iocoder/graduation/README

+------------------------------------------------------------------------------+
|                            MY GRADUATION PROJECT                             |
+------------------------------------------------------------------------------+

             ,----------------,              ,---------,
        ,-----------------------,          ,"        ,"|
      ,"                      ,"|        ,"        ,"  |
     +-----------------------+  |      ,"        ,"    |
     |  .-----------------.  |  |     +---------+      |
     |  |                 |  |  |     | -==----'|      |
     |  |  I LOVE MIPS!   |  |  |     |         |      |
     |  |  QUAFIOS> _     |  |  |/----|`---=    |      |
     |  |                 |  |  |   ,/|==== ooo |      ;
     |  |                 |  |  |  // |(((( [33]|    ,"
     |  `-----------------'  |," .;'| |((((     |  ,"
     +-----------------------+  ;;  | |         |,"
        /_)______________(_/  //'   | +---------+        <from asciiworld.com>
   ___________________________/___  `,
  /  oooooooooooooooo  .o.  oooo /,   \,"-----------
 / ==ooooooooooooooo==.o.  ooo= //   ,`\--{)B     ,"
/_==__==========__==_ooo__ooo=_/'   /___________,"
`-----------------------------'

Manifesto:
----------
doc/        Detailed documentation for my work
firmware/   Firmware program for MIPS computer
hardware/   VHDL code for the machine
mipsemu/    MIPS computer emulator
quafios/    Quafios operating system
vhdsim/     VHDL code simulation with nvc (VHPI)

Notes:
------
-> You need gcc and SDL to compile the emulator (mipsemu).
-> You need to cross compile binutils, gcc, and libgcc to compile the firmware
   * Note: before you compile libgcc, please add 'HOST_LIBGCC2_CFLAGS=-mxgot'
     to 'libgcc/config/mips/t-mips' file in gcc source code.
