iocoder/graduation/doc/book/poster.pdf

## MIPS COMPUTER ON FPGA

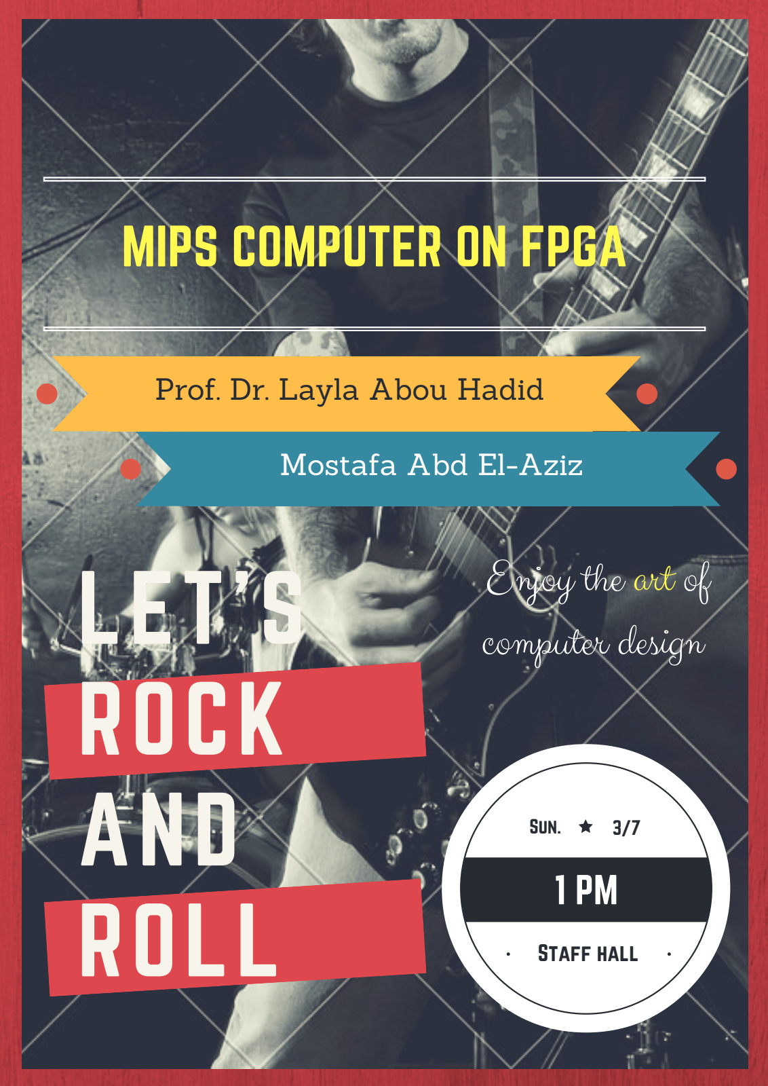
[picture p35: page 1]

# LET'S ROCK AND ROLL

Prof. Dr. Layla Abou Hadid

Mostafa Abd El-Aziz

Sun. 3/7

### 1 PM

Staff hall

## Enjoy the art of computer design
