iocoder/graduation/doc/presentation/presentation.pdf

# MIPS COMPUTER ON FPGA

## Supervisor: Professor Layla Abou Hadid Team: Mostafa Abd El-Aziz

# Overview

- The target of the project is to build a general-purpose computer system on FPGA.
- General-purpose computer?
- FPGA: Spartan-3E chip on Nexys II development board.

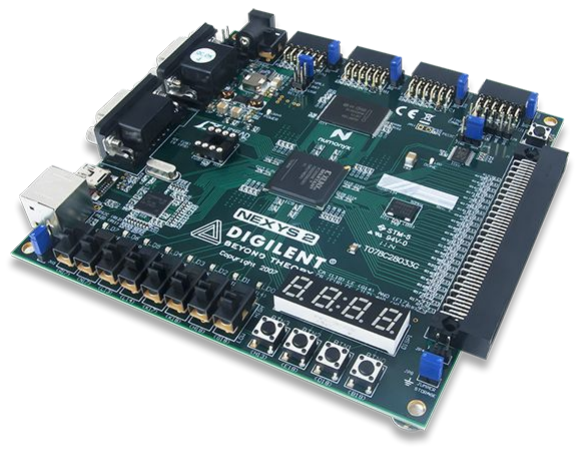
[picture p36: figure]
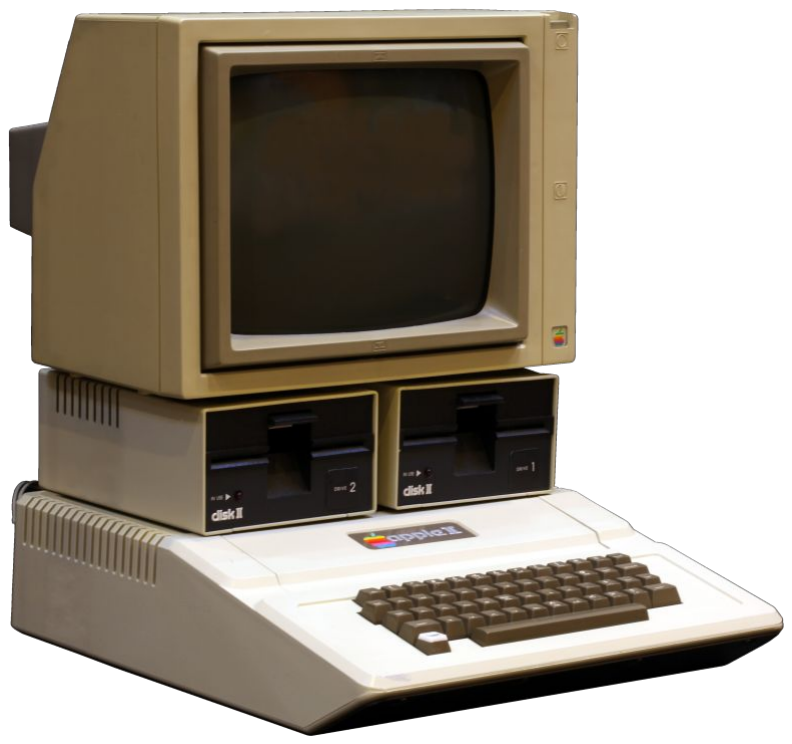
[picture p37: figure]

# WHY?

- Argument: There are tons of MIPS processors implemented in VHDL and Verilog!
- Fallacy: MIPS processors… not MIPS computers.
- Research the capabilities of FPGAs vs. capabilities of modern micro-computers.
- Computer architecture education in CSED (That’s why we chose MIPS).
- Processor-oriented education vs. system-oriented education (Clements vs. Peterson).
- Fun.

# Goal

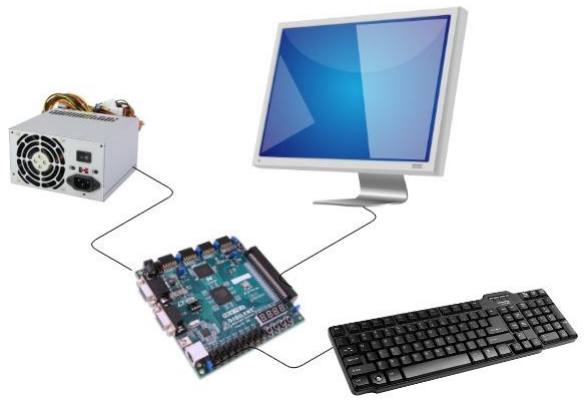
[picture p38: figure]

- General-purpose computer:
- Capabilities?
- Limitations?
- Users: Gamers - Students - Hobbyists
- Processor: MIPS-I ISA (pipeline, cache, and paging).
- Interfaces: VGA (output) and PS/2 (input).
- Hardware: MIPS processor + I/O interfaces in VHDL.
- Software: Firmware and OS [Quafios].

# Outline

- High-Level Architecture
- System components:
- Processor
- Memory
- VGA
- PS/2 Keyboard
- Interrupt Subsystem
- Timer
- Emulation
- Software
- Firmware
- OS
- Conclusion

# Outline

- High-Level Architecture
- System components:
- Processor
- Memory
- VGA
- PS/2 Keyboard
- Interrupt Subsystem
- Timer
- Emulation
- Software
- Firmware
- OS
- Conclusion

# System Architecture

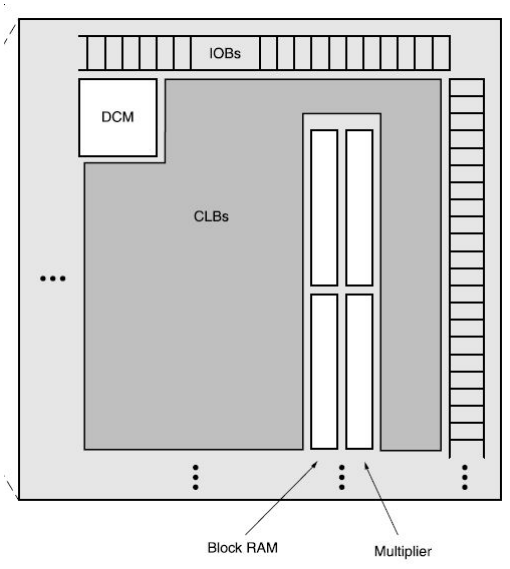
[picture p39: figure]

- Challenges:
- Low clock rate.
- LUTs, multiplexers, adders, etc…
- Block RAMs: only 20 slices.
- Limited distributed RAM.
- Timing constraints!
- These limited resources led to various design decisions:
- The choice of MIPS architecture (RISC merits).
- Direct-mapped TLB and caches.
- Text-mode VGA.
- Precise exceptions.

# System Architecture: High Level

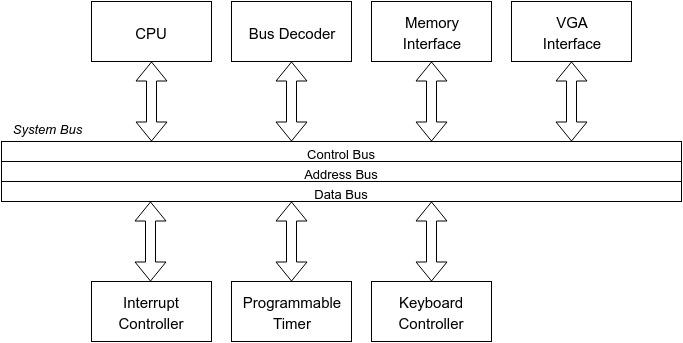
[picture p40: figure]

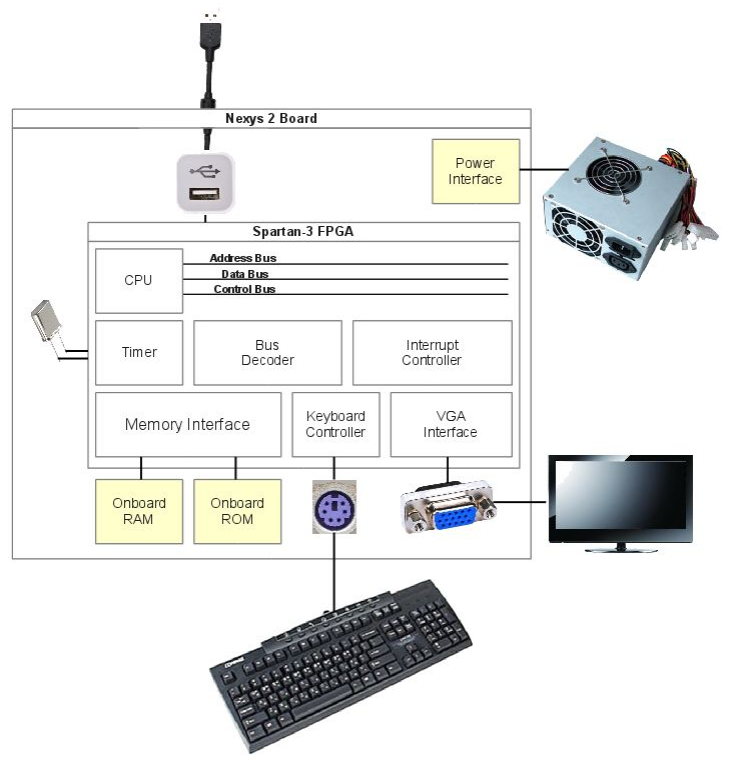
[picture p41: figure]

# System Architecture: High Level

# Outline

- High-Level Architecture
- System components:
- Processor
- Memory
- VGA
- PS/2 Keyboard
- Timer
- Interrupt Controller
- Emulation
- Software
- Firmware
- OS
- Conclusion

# Central Processing Unit (1/6)

- The CPU consists of three components:
- The core (pipeline).
- Caching sub-system: instruction cache and data cache.
- Software-controlled translation-lookaside buffer (TLB).
- The CPU is actually an implementation of MIPS-I instruction set architecture:
- 58 instructions: memory access, ALU, branch/jump, and misc instructions.
- 32 general purpose registers + HI and LO registers.
- Additions (compatible with IDT’s R3000):
- Control instructions: MFC0, MTC0, TLBR, TLBWI, and RFE.
- Control registers: Index, EntryLo, BadVaddr, EntryHi, SR, Cause, and EPC.
- Transparent cache.
- Software-controlled TLB.

# Pipeline

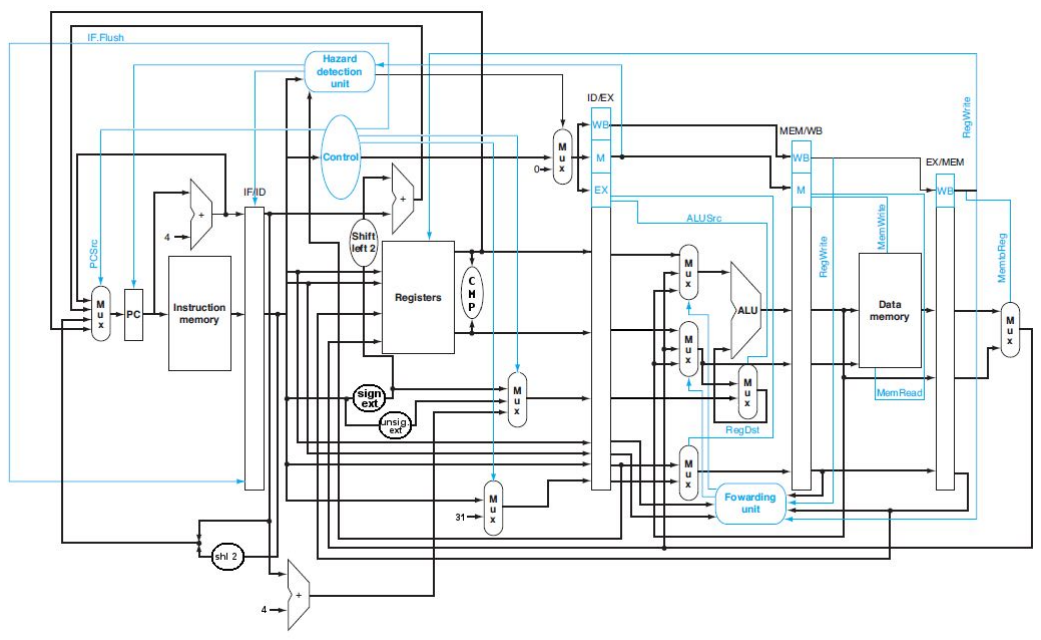
[picture p42: figure]

# Address Translation

# Address Translation

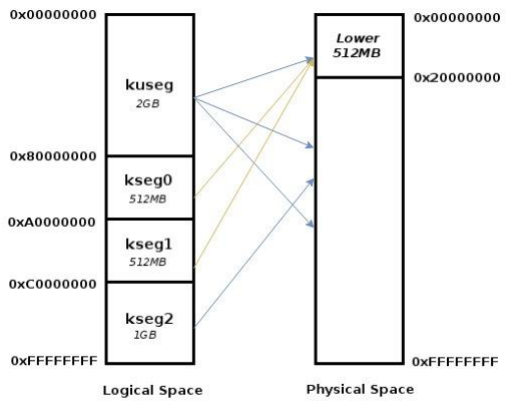
[picture p43: figure]

# Memory (2/6)

- MIPS-I physical address space is 4GB.
- Nexys II board contains two memory chips:
- 16MB Pseudo-static RAM chip.
- 16MB ROM chip.
- VHDL interface between the chips and system bus.
- Memory-mapped I/O

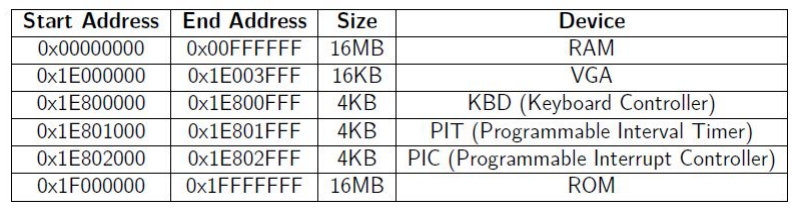
[picture p44: figure]

# VGA Interface (3/6)

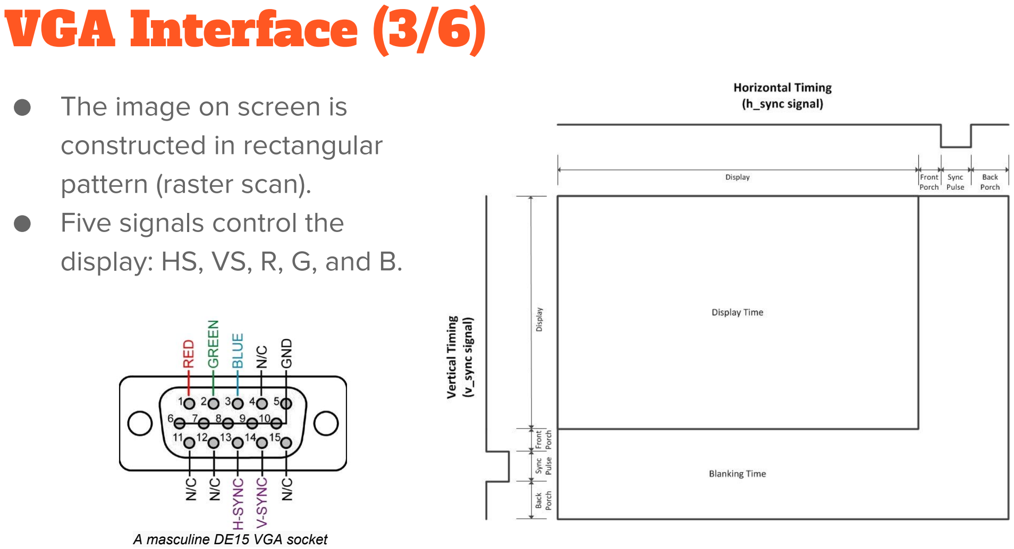
[picture p45: page 16]

- The image on screen is
constructed in rectangular pattern (raster scan).
- Five signals control the display: HS, VS, R, G, and B.

A masculine DE15 VGA socket

# VGA Interface: CRT Screen

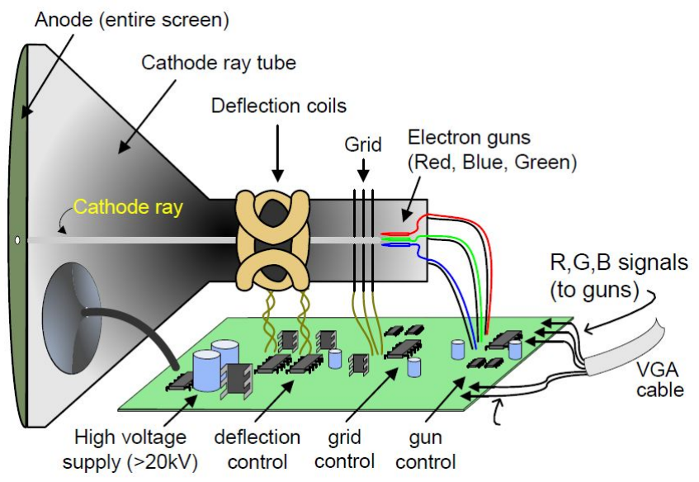
[picture p46: figure]

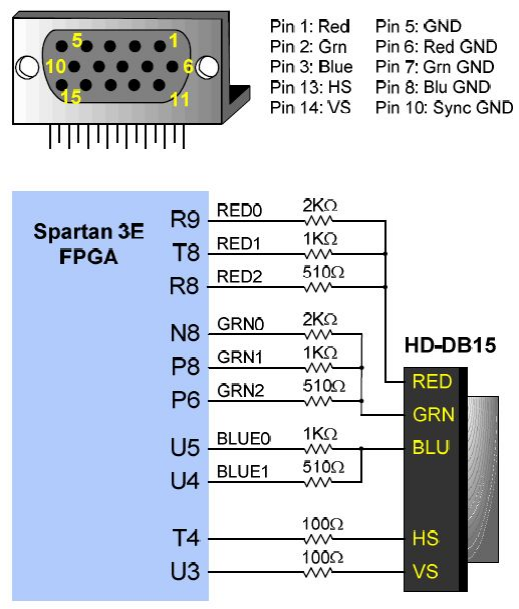
[picture p47: figure]

# VGA Interface

- Nexys II board provides a DE15 VGA port. HS and VS signals are directly connected to the Spartan 3E FPGA chip.
- Since R, G, and B are analog singnals, a DAC circuit is put between FPGA chip and VGA
port.
- FPGA could produce 8 levels of red color, 8 levels of green, and 4 levels of blue (total 256 colors).

# VGA Interface

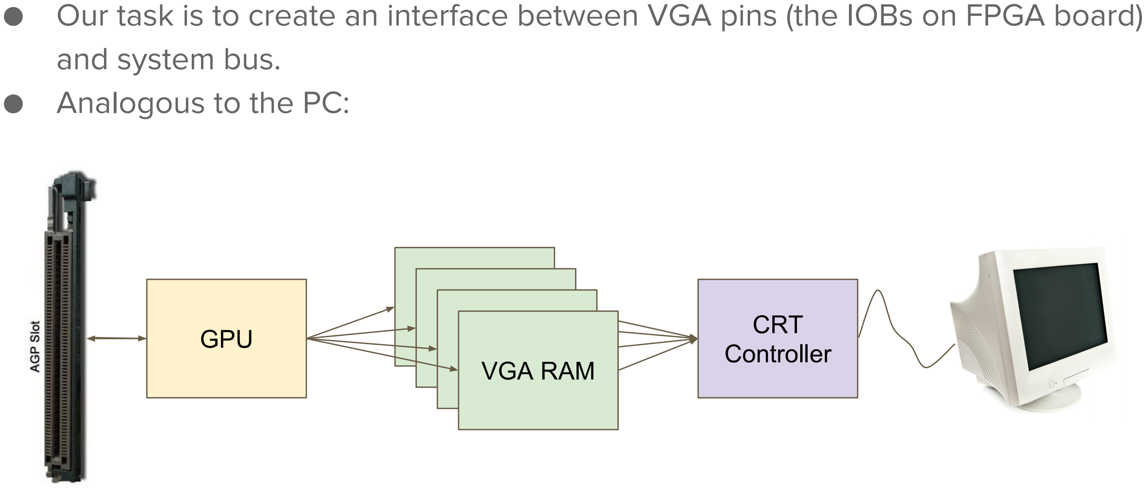
[picture p48: figure]
and system bus. ● Analogous to the PC:; GPU; CRT; Controller; VGA RAM VGA RAM VGA RAM VGA RAM

- Our task is to create an interface between VGA pins (the IOBs on FPGA board)

# VGA Interface

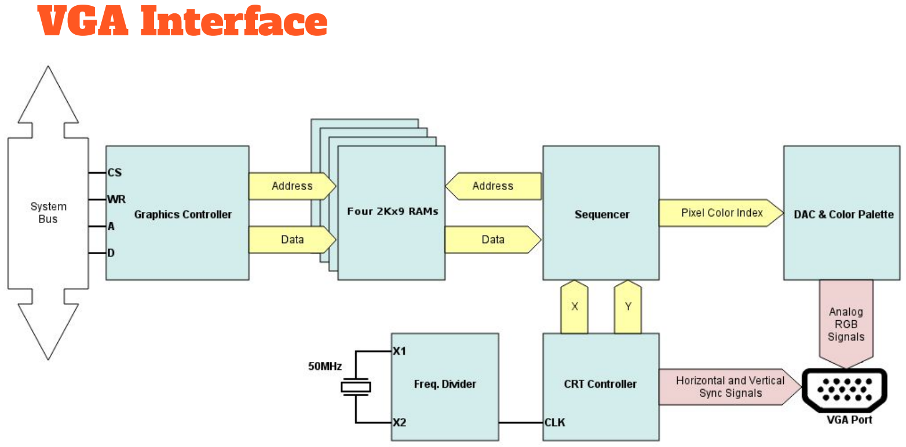
[picture p49: page 20]

# VGA Interface

- Resolution: 720x400.
- Framebuffer size → VGA supports text mode only.
- 80 columns, 25 rows. Cell size: 9x16.
- Framebuffer consists of four 2Kx9 memories:
- Character memory (bank 0)
- Attribute memory (bank 1)
- Font memory (bank 2 and 3).

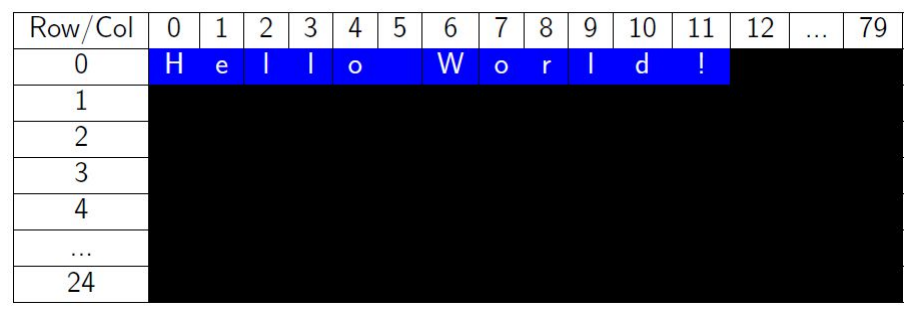
[picture p50: figure]
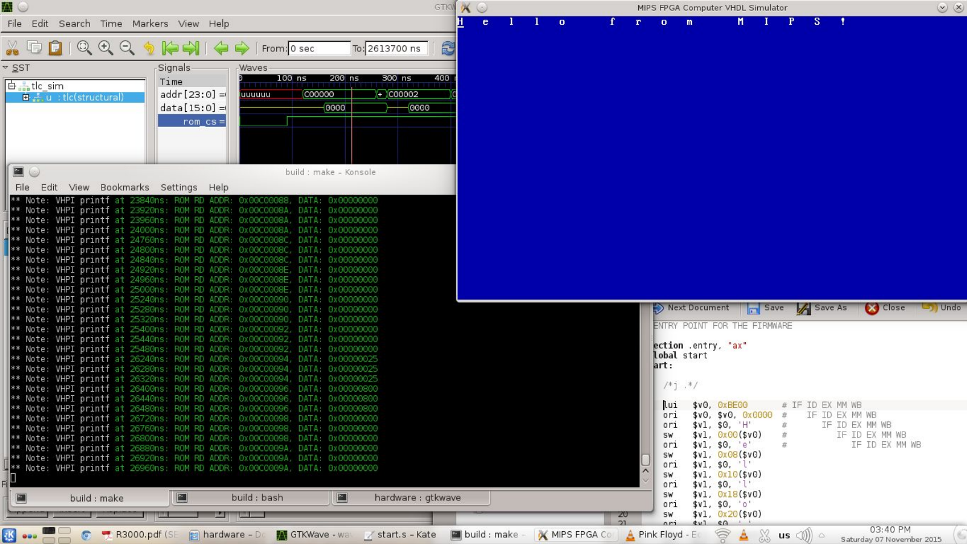
[picture p51: page 22]

# PS/2 Interface (4/6)

- A PS/2 port is mounted on Nexys II board.

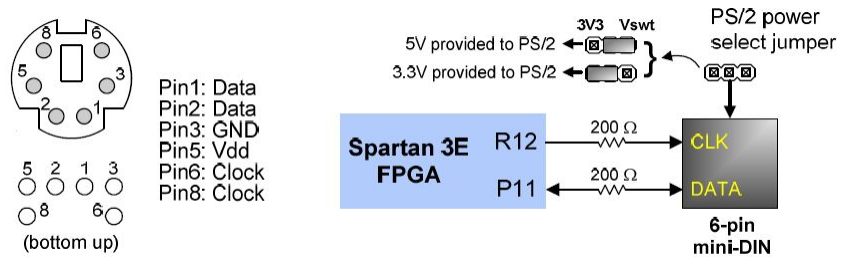
[picture p52: figure]

# PS/2 Interface

- When the user presses down (or up) one of the keys on the keyboard, a specific scan code is transmitted by the PS/2 keyboard (through CLK and DATA signals).

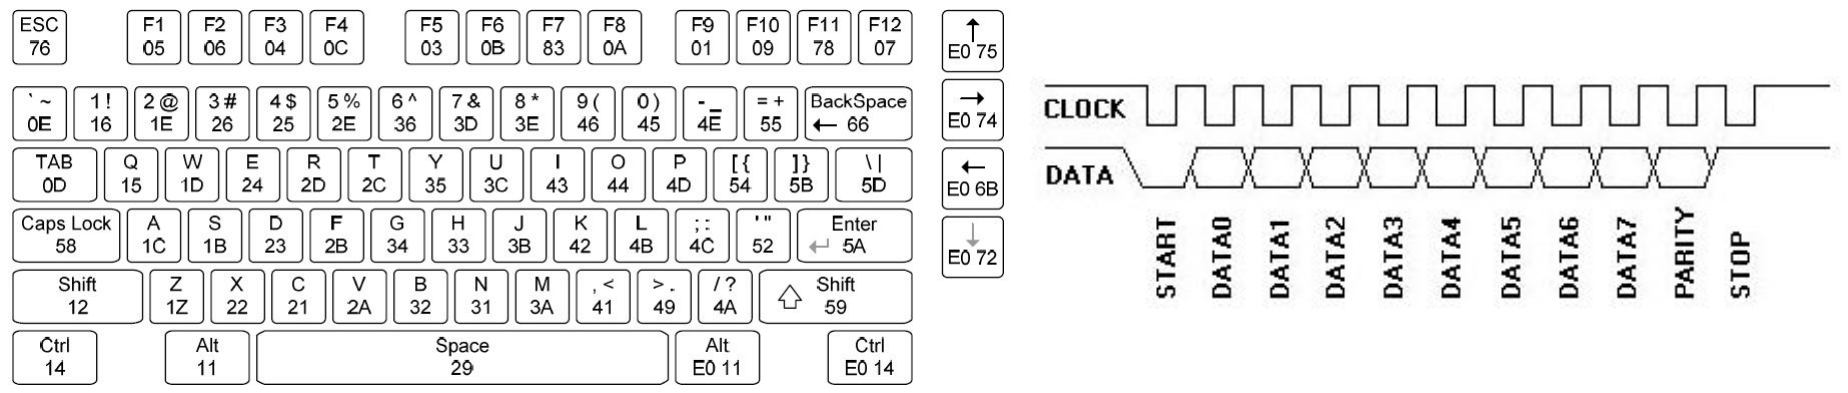
[picture p53: figure]

# PS/2 Interface

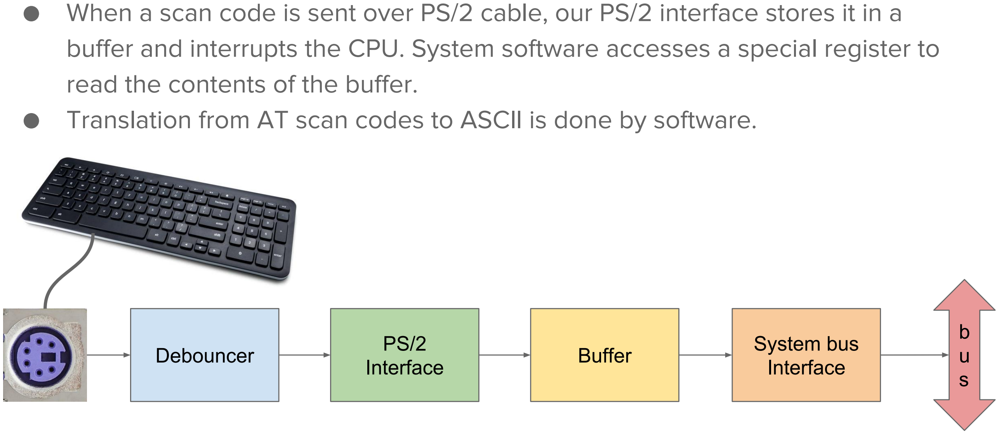
[picture p54: figure]
read the contents of the buffer.; Debouncer; Buffer; System bus; Interface; PS/2 Interface

- When a scan code is sent over PS/2 cable, our PS/2 interface stores it in a buffer and interrupts the CPU. System software accesses a special register to
- Translation from AT scan codes to ASCII is done by software.

# Programmable Timer (5/6)

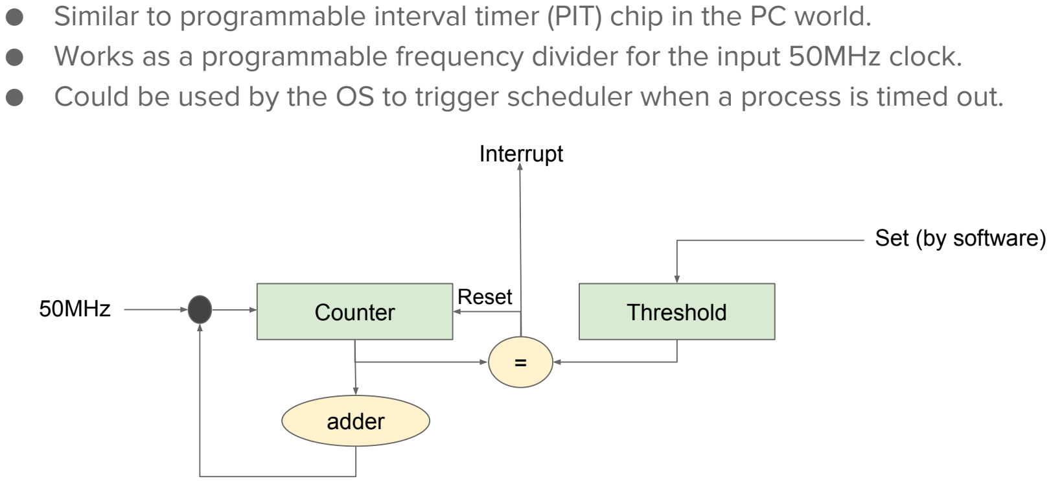
[picture p55: figure]
Counter; Threshold; adder; 50MHz; Reset; Set (by software); Interrupt

- Similar to programmable interval timer (PIT) chip in the PC world.
- Works as a programmable frequency divider for the input 50MHz clock.
- Could be used by the OS to trigger scheduler when a process is timed out.

# Interrupt Controller (6/6)

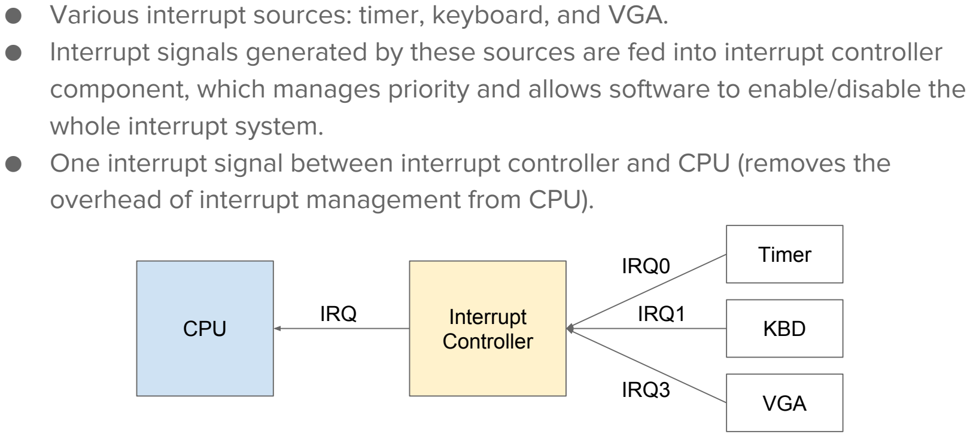
[picture p56: figure]
whole interrupt system.; CPU; Interrupt; Controller; Timer; KBD; VGA; IRQ; IRQ0; IRQ1; IRQ3

- Various interrupt sources: timer, keyboard, and VGA.
- Interrupt signals generated by these sources are fed into interrupt controller component, which manages priority and allows software to enable/disable the
- One interrupt signal between interrupt controller and CPU (removes the overhead of interrupt management from CPU).

# Architecture Summary

- System components:
- CPU
- Memory (16MB RAM + 16MB ROM)
- I/O devices (VGA, keyboard, timer, interrupt controller)
- All components are connected to a shared bus (system bus).
- Components are implemented in VHDL and uploaded to FPGA chip.

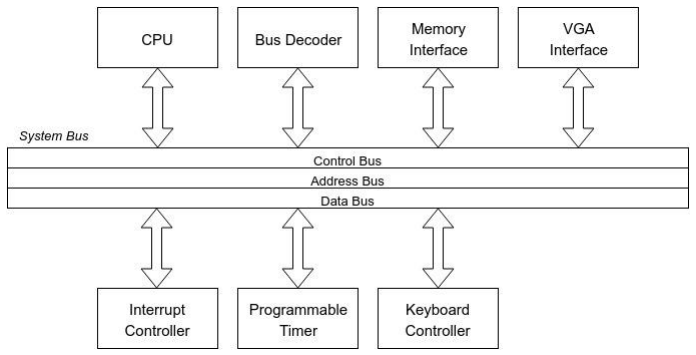
[picture p57: figure]

# Outline

- High-Level Architecture
- System components:
- Processor
- Memory
- VGA
- PS/2 Keyboard
- Timer
- Interrupt Controller
- Emulation
- Software
- Firmware
- OS
- Conclusion

# Emulation

- One architecture; several implementations:
- FPGA implementation.
- VHDL simulation (very slow).
- Emulator in C over GNU/Linux.
- The emulator replicates the architecture we explained earlier.
- Work on the emulator started with the start of the project. We used it to validate the design before testing on FPGA.

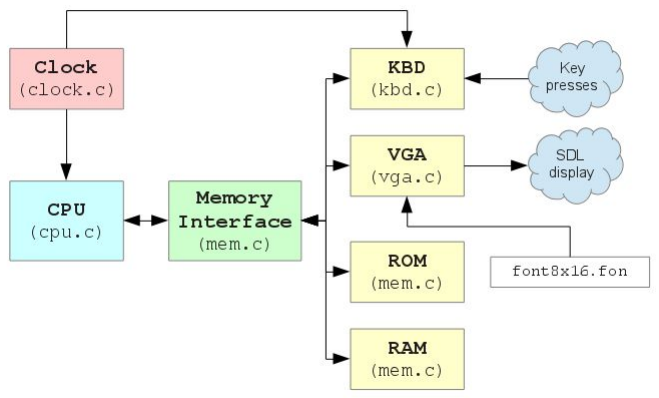
[picture p58: figure]

# Outline

- High-Level Architecture
- System components:
- Processor
- Memory
- VGA
- PS/2 Keyboard
- Timer
- Interrupt Controller
- Emulation
- Software
- Firmware
- OS
- Conclusion

# Firmware

- Stored on the 16MB ROM chip.
- Aligned such that the physical address of the first instruction of the firmware program = MIPS Reset Vector.
- Tasks:
- Boots up the system.
- Initializes hardware.
- Performs PoST.
- Loads the OS.
- Provides an interface between the OS and hardware (before the OS loads its own drivers).

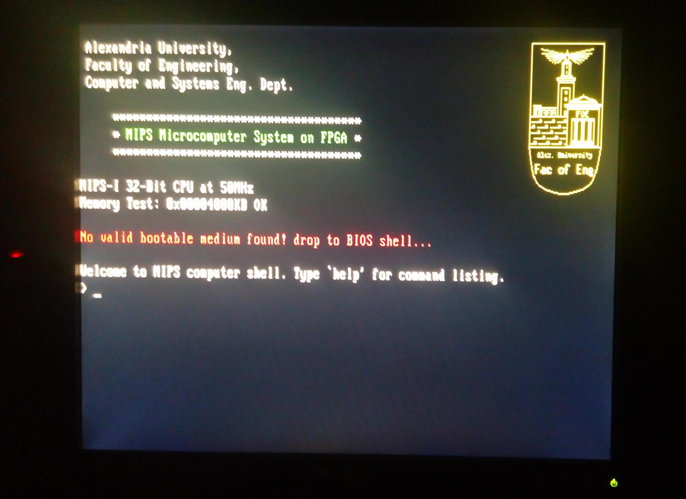
[picture p59: page 33]
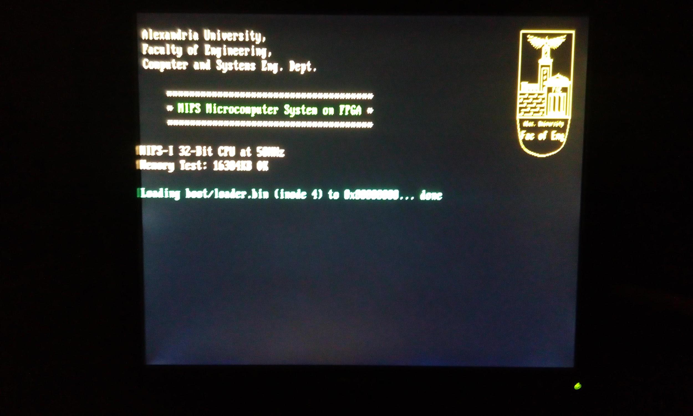
[picture p60: page 34]

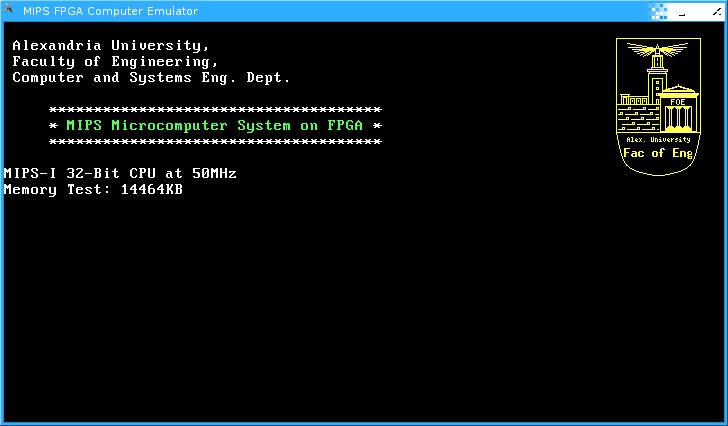
[picture p61: figure]

# Operating System

- We chose to port Quafios OS to our system.
- Quafios was written for IBM PC, but it was designed to be portable. So we only modified the architecture-dependent part of the kernel and added device drivers for our machine.
- Quafios kernel: monolithic
- Architecture-dependant code.
- Memory manager (pmem, kmem, umem).
- Filesystem (VFS, diskfs, tmpfs, devfs, and sysfs).
- Device drivers.
- Process manager and scheduler.

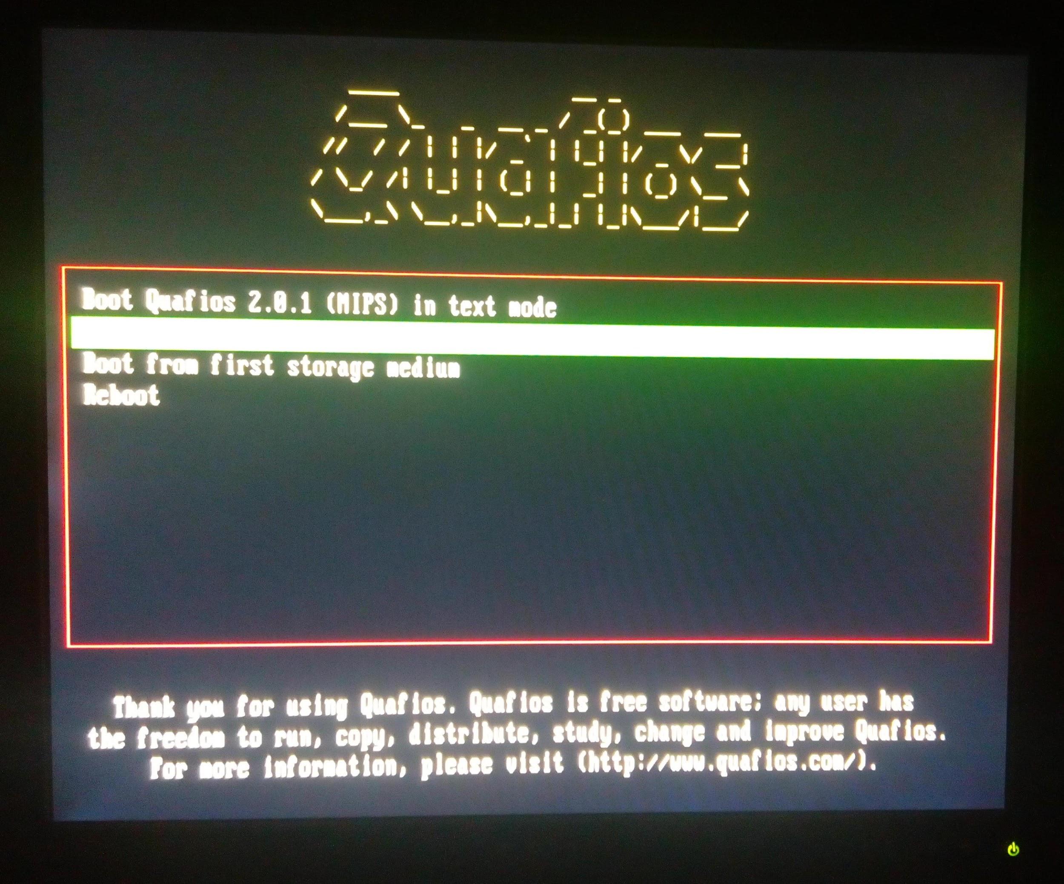
[picture p62: page 37]
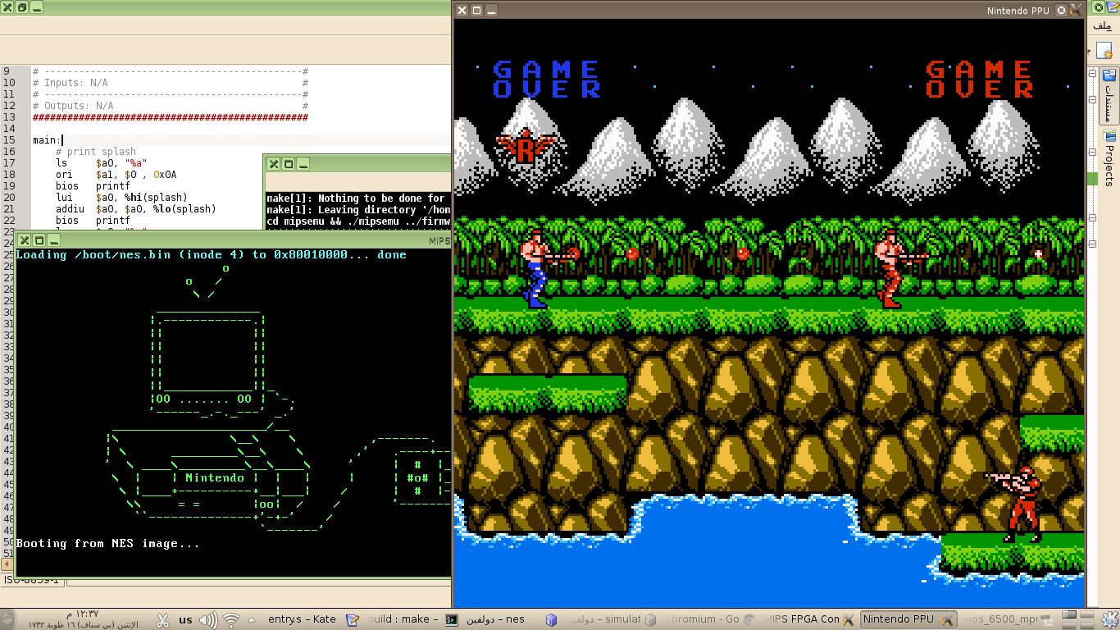
[picture p63: page 38]

# Outline

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

# Conclusion

- We implemented a general-purpose computer using Nexys II FPGA board with Spartan-3E FPGA chip.
- Hardware:
- CPU (implementation for MIPS-I instruction set with cache and TLB).
- Memory interface: 16MB ROM chip + 16MB RAM chip.
- I/O devices: VGA, keyboard, timer, and interrupt controller.
- Emulator.
- Software: Firmware + Quafios.
- Future Work:
- Improvements for the pipeline.
- Sound, USB, SDCard, Ethernet, and other interfaces.

# Thank You
