iocoder/graduation/doc/book/cpu.tex

\documentclass[]{scrartcl}

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

% listings
\usepackage{listings}
\lstset{language=java}

% margins
\usepackage[margin=3cm,a4paper]{geometry}

% figures and tables
\usepackage{graphicx}
\usepackage{float}
\usepackage{multirow}
\usepackage{tikz}

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

% section style
\usepackage{enumitem}
\usepackage{sectsty}
\sectionfont{\LARGE}

% page orientation
\usepackage{lscape}

%------------------------------------------------------------------------------%

\begin{document}

% university logo
\titlehead{

    \small Alexandria University\\
    \small Faculty of Engineering\\
    \small Computer and Systems Engineering Department\\
    \small CS 402 - Graduation Project

    \vspace{-2.2cm}
    \hfill
    
}

% document title
\maketitle

% table of contents
\renewcommand{\contentsname}{Table of Contents}
\tableofcontents

%------------------------------------------------------------------------------%

\section{Central Processing Unit}

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

Before going into details, we shall define two keywords that will be used
throughout the section:

\begin{itemize}

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

\end{itemize}

The following subsections are divided into two sets corresponding to
the two titles described above; Until subsection 5 (inclusive), we are just
talking about the architecture. It's not before subsection 6 where we
start to show how we implement the behaviour described in earlier
subsections. Programmers can skip subsections 6, 7, 8, and 9.\\

Here we summarize what the subsections are about (SS\# = subsection \#):

\begin{enumerate}[label=SS\arabic*.]

\item an introduction to the basics of the architecture of our CPU.
\item detailed description for the architectural registers.
\item interrupt and exception handling.
\item paging and translation look-aside buffer (TLB).
\item caching as seen by the programmer.
\item introduction to the VHDL implementation of our CPU.
\item VHDL implementation for the pipeline.
\item VHDL implementation for interrupts and exceptions.
\item VHDL implementation for the cache and TLB.

\end{enumerate}

\subsection{Introduction}

CPU instruction (also called order, operation) is the basic unit
of execution. The main task of a processor is to execute a sequence
of instructions (i.e, program) which shall have effect on the state
of the processor and devices connected with the processor.\\

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

Every word in memory has an address, that also means that every
instruction in memory has an address called `instruction address'.
CPU maintains a register that stores the instruction address of
next instruction to fetch, called program counter (PC). When an
instruction is fetched, program counter is increased by 4 (number
of bytes in word) without touching lower 2 bits (they are
always zero), a behaviour which implies that:

\begin{itemize}

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

\item Instructions should always be stored in 4-byte aligned words.

\end{itemize}

It is important to note that MIPS-I instruction set is a proper
subset of the instruction set of our processor; meaning that
the processor supports additional instructions and registers that 
control the behaviour of the processor as will be seen below.\\

CPU instructions are divided into the following groups:

\begin{enumerate}

\item Load and Store
\item ALU
\item Jump and Branch
\item Miscellaneous
\item Control

\end{enumerate}

\subsubsection{Load and Store Instructions}

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

\begin{itemize}

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

\end{itemize}

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

\begin{enumerate}

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

\end{enumerate}

The detailed behaviour of those instructions is described
in the appendix.\\

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

\begin{itemize}

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

\end{itemize}

\subsubsection{ALU Instructions}

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

\begin{enumerate}

\item ALU instructions with an immediate operand
\item ALU instructions with three operands
\item Shift instructions
\item Multiply and divide instructions.

\end{enumerate}

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

\begin{itemize}
\item 

\textbf{\underline{ALU Instructions With Immediate Operand:}} \\

The reader may expect that the first group (ALU instructions
with immediate operand) is encoded exactly the same way as
memory instructions. Both groups are included in the same
encoding class (called I-TYPE) as will be seen later in
the encoding subsubsection. Just like memory instructions,
an ALU instruction with an immediate operand shall consist
of the following fields:

\begin{itemize}

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

\end{itemize}

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

\begin{enumerate}

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

\end{enumerate}

The detailed behaviour of those instructions is described
in the appendix.\\

\item \textbf{\underline{R-TYPE ALU Instructions:}} \\

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

\begin{itemize}

\item \textbf{Opcode}: always zero. (6 bits)

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

\begin{enumerate}

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

\end{enumerate}

The third group (shift instructions) contains the following instructions:

\begin{enumerate}

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

\end{enumerate}

Finally, following is a listing for all instructions in the last
group (multiply/divide instructions):

\begin{enumerate}

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

\end{enumerate}

For detailed description for the behaviour of all of the instructions listed
above, please refer to the appendix.

\end{itemize}

\subsubsection{Jump and Branch Instructions}

MIPS-I architecture defines a number of operations that control the path
of execution. Jump instruction shall unconditionally modify PC register,
while branch instructions modify PC register only when the condition
specified within the instruction word is tautology.\\

Jump and branch instructions are divided into four groups:

\begin{enumerate}

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

\end{enumerate}

Next we illustrate every group in detail.

\begin{itemize}

\item \textbf{\underline{Jump Instructions Jumping Within 256MB Region:}} \\

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

\begin{itemize}

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

\end{itemize}

This group only contains two instructions:

\begin{enumerate}

\item \textbf{J}:   Jump
\item \textbf{JAL}: Jump and Link

\end{enumerate}

\item \textbf{\underline{Jump Instructions to Absolute Address:}} \\

Second group (jump instructions to absolute address) consists of instructions
similar to instructions of the first group, yet have the ability to jump
to any memory location, not just locations inside the current 256MB region.
These instructions are encoded as R-TYPE like most ALU instructions, thus
the instruction word shall consist of the following fields:

\begin{itemize}

\item \textbf{Opcode}: always zero. (6 bits)

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

\item \textbf{Source register 2}: must be zero. (5 bits)

\item \textbf{Destination register}: for JALR instruction, this field
                                     contains the address of the register
                                     where return address shall be stored.
                                     For JAL instruction, this field should
                                     be zero.

\item \textbf{Shift amount}: must be zero. (5 bits)

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

Analogous to the first group, this group consists of these two instructions:

\begin{enumerate}

\item \textbf{JR}:   Jump Register
\item \textbf{JALR}: Jump and Link Register

\end{enumerate}

\item \textbf{\underline{Conditional Branch Instructions
                         Comparing 2 Registers:}} \\

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

\begin{itemize}

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

\end{itemize}

The group consists of the following instructions:

\begin{enumerate}

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

\end{enumerate}

\item \textbf{\underline{Conditional Branch Instructions 
                         Comparing Against Zero:}} \\

The fourth group is also encoded as I-TYPE instructions,
however, the fields shall have special values and meanings:

\begin{itemize}

\item \textbf{Opcode}: always one. (6 bits)

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

\item \textbf{Destination register}: used as an extension to the opcode field.
                                     This field shall contain a unique
                                     identifier for the operation to be
                                     performed. (5 bits)

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

\end{itemize}

Finally, this last group consists of the following instructions:

\begin{enumerate}

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

\end{enumerate}

For detailed description for the behaviour of all of the instructions listed
above, please refer to the appendix.

\end{itemize}

\subsubsection{Miscellaneous Instructions}

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

The format of this class of instructions is similar to R-TYPE,
with the `code' field replacing source register,
target register, destination register, and shift amount fields:

\begin{itemize}

\item \textbf{Opcode}: always zero. (6 bits)

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

\end{itemize}

This group consists of the following instructions:

\begin{enumerate}

\item \textbf{SYSCALL}: System Call
\item \textbf{BREAK}:   Breakpoint

\end{enumerate}

For detailed description for the behaviour of all of the instructions listed
above, please refer to the appendix.

\subsubsection{Control Instructions}

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

In this document, we shall use the keyword `control instructions' to
refer to this group of instructions. Control instructions are R-TYPE
instructions with the following fields:

\begin{itemize}

\item \textbf{Opcode}: always 16. (6 bits)

\item \textbf{Source register 1}: used to specify type of instruction.
                                  (5 bits)

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

\item \textbf{Shift amount}: must be zero. (5 bits)

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

\end{itemize}

The following list shows the instructions contained in this group:

\begin{enumerate}

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

\end{enumerate}

For detailed description for the behaviour of all of the instructions listed
above, please refer to the appendix.

\subsubsection{Instruction Encoding Summary}

As seen above, all instructions are encoded using either R-TYPE, I-TYPE,
or J-TYPE format. Figure \ref{formats} summarizes the three formats and their
corresponding fields. Note that field use/meaning depends on the
encoded instruction itself, not the format.\\

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

\subsubsection{Addressing Modes}

Figure \ref{addrmodes} summarizes all possible addressing modes
along with instructions that support them:

\begin{figure}[H]
\begin{center}
\resizebox{0.9\textwidth}{!} {
\begin{tabular}{|c|c|}

\hline \textbf{Addressing Mode} &
       \textbf{Corresponding Instructions} \\

\hline Register, [Base Register]+Immediate Offset &
       Load/Store Instructions \\

\hline Register, Register, Immediate &
       ALU Instructions with Immediate Operand \\

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

\hline Register, Register, Shift Amount &
       SLL, SRL, and SRA \\

\hline Register, Register &
       MULT, MULTU, DIV, and DIVU \\

\hline Register &
       MFHI, MTHI, MFLO, and MTLO \\

\hline Absolute Address Within 256MB Segment &
       Jump Instructions Jumping Within 256MB Region \\

\hline Register Absolute &
       Jump Instructions to Absolute Address \\

\hline Register, Register, PC-Relative Immediate &
       Branch Instructions Comparing 2 Registers \\

\hline Register, PC-Relative Immediate &
       Branch Instructions Comparing Against Zero \\

\hline Immediate Code &
       Exception Instructions \\

\hline Register, Control Register &
       MFC0 and MTC0 \\

\hline Implicit &
       TLBR, TLBWI, and RFE \\

\hline

\end{tabular}
}
\end{center}
\caption{All possible addressing modes}
\label{addrmodes}
\end{figure}

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

\subsubsection{Programmer-Visible Pipeline Effects}

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

\begin{itemize}

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

\item \textbf{Load data not available}: If a memory load instruction is
      followed by an ALU instruction that requires the data
      acquired by the load instruction (addresses the same
      register), a data hazard will occur since ALU must wait
      until MEM unit is done fetching data from memory. This
      shall delay the execution of the ALU instruction by
      one delay slot (stalls the pipeline for one slot).

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

\item \textbf{Cache misses}:
      The pipeline shall stall if the instruction to
      be fetched or data specified by load instruction is not in cache.
      Furthermore, store instructions would always stall the pipeline
      since the cache system is write-through. This means that an
      instruction will take more than one CPU clock cycle if a cache
      miss happens.

\item \textbf{Unaligned memory access}:
      This class of instructions shall take
      more than one CPU clock cycles because atomic access to unaligned
      word is not possible.

\end{itemize}

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

\subsection{Registers}

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

In addition to registers defined by MIPS standard, our processor
contains special registers that control the behaviour of the processor,
called `control registers'. Surprisingly, control registers are
accessible through control instructions.\\ 

\subsubsection{General-Purpose Registers}

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

\begin{enumerate}

\item Register 0 is always zero, no matter what value the programmer
      writes to it.

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

\end{enumerate}

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

\begin{figure}[H]
\begin{center}
\resizebox{0.9\textwidth}{!} {
\begin{tabular}{|c|c|c|}

\hline \textbf{Reg\#} & \textbf{Name}  & \textbf{Description} \\

\hline 0     & zero  & Always zero \\

\hline 1     & at    & Used by assembler ($at = assembler\ temporary$) \\

\hline 2-3   & v0-v1 & Value returned by subroutine \\

\hline 4-7   & a0-a3 & Subroutine parameters ($a\# = argument\#$) \\

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

\hline 16-23 & s0-s7 & Must be saved before use 
                       ($s\# = subroutine\_var\#$) \\

\hline 26-27 & k0-k1 & Used by exception handler \\

\hline 28    & gp    & Global pointer \\

\hline 29    & sp    & Stack pointer \\

\hline 30    & s8/fp & 9th register variable/frame pointer \\

\hline 31    & ra    & Return address \\

\hline

\end{tabular}
}

\end{center}
\caption{Conventional names/uses of MIPS registers}
\label{regs}
\end{figure}

\subsubsection{LO and HI Registers}

Along with the 32 registers defined above, two special registers
are defined by the MIPS architecture to store results of MULT, MULTU,
DIV, and DIVU instructions. Since these four instructions produce
64-bit results, they need two destination registers. Since MIPS 
architecture doesn't define more than one destination register
for an instruction (for hardware considerations), the result
should first stored in an intermediate 64-bit register (or two
parallel 32-bit registers) then moved to the GPRs in two steps.\\
 
The intermediate registers are called LO and HI registers. Each
one of them is 32-bit wide, so you can see them as one 64-bit
register which is can be accessed in halfs. LO
and HI can be read using MFLO and MFHI instructions, each of which
copies the value of LO or HI register into a general-purpose register.
The HI and LO registers can also altered by MTLO and MTHI instructions.

\subsubsection{Control Registers}

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

\begin{figure}[H]
\begin{center}
\resizebox{0.9\textwidth}{!} {
\begin{tabular}{|c|c|c|}

\hline \textbf{Reg Indx} & \textbf{Name}  & \textbf{Description} \\

\hline 0     & Index    & Stores index of TLB entry to be read/written \\

\hline 2     & EntryLo  & The lowest half of TLB entry to be read/written \\

\hline 9     & BadVaddr & Stores the memory address that caused TLB miss \\

\hline 10    & EntryHi  & The highest half of TLB entry to be read/written \\

\hline 12    & SR       & Status register \\

\hline 13    & Cause    & Exception type \\

\hline 14    & EPC      & Address of the instruction that caused an exception\\

\hline

\end{tabular}
}

\end{center}
\caption{Control registers}
\label{ctrlregs}
\end{figure}

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

\begin{itemize}

\item \textbf{\underline{Index Register:}}\\

\begin{figure}[H]
\begin{center}
\begin{tabular}{|c|c|c|c|c|}

\hline \multicolumn{5}{|c|}{Index Register (0)} \\

\hline \textbf{Field bit(s):} & 31 & 30..14 & 13..8 & 7..0 \\

\hline \textbf{Field name:}   & 0  & x      & Index & x    \\

\hline

\end{tabular}

\end{center}
\caption{Format of Index register}
\label{index_reg}
\end{figure}

Detailed description for fields in figure \ref{index_reg}:

\begin{itemize}

\item \textbf{Index}: Before the operating system reads
      or modifies a TLB entry, it shall first write the 
      index for the target TLB entry in this field using
      MTC0 instruction. After then, the OS issues a TLB
      read or TLB write using TLBR or TLBWI instruction.
      Index takes a value from 0 to 63, which implies
      that our TLB has 64 entries.

\end{itemize}

\item \textbf{\underline{EntryLo Register:}}\\

\begin{figure}[H]
\begin{center}
\begin{tabular}{|c|c|c|c|c|}

\hline \multicolumn{5}{|c|}{EntryLo Register (2)} \\

\hline \textbf{Field bit(s):} & 31..12 & 11..10 & 9 & 8..0 \\

\hline \textbf{Field name:}   & PFN    & 0      & V & 0    \\

\hline

\end{tabular}

\end{center}
\caption{Format of EntryLo register}
\label{entrylo_reg}
\end{figure}

Detailed description for fields in figure \ref{entrylo_reg}:

\begin{itemize}

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

\end{itemize}

\item \textbf{\underline{BadVaddr Register:}}\\

\begin{figure}[H]
\begin{center}
\begin{tabular}{|c|c|}

\hline \multicolumn{2}{|c|}{BadVaddr Register (9)} \\

\hline \textbf{Field bit(s):} & 31..0    \\

\hline \textbf{Field name:}   & BadVaddr \\

\hline

\end{tabular}

\end{center}
\caption{Format of BadVaddr register}
\label{badvaddr_reg}
\end{figure}

Detailed description for fields in figure \ref{badvaddr_reg}:

\begin{itemize}

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

\end{itemize}

\item \textbf{\underline{EntryHi Register:}}\\

\begin{figure}[H]
\begin{center}
\begin{tabular}{|c|c|c|}

\hline \multicolumn{3}{|c|}{EntryHi Register (10)} \\

\hline \textbf{Field bit(s):} & 31..12 & 11..0 \\

\hline \textbf{Field name:}   & VPN    & 0     \\

\hline

\end{tabular}

\end{center}
\caption{Format of EntryHi register}
\label{entryhi_reg}
\end{figure}

Detailed description for fields in figure \ref{entryhi_reg}:

\begin{itemize}

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

\end{itemize}

\item \textbf{\underline{Status Register:}}\\

\begin{figure}[H]
\begin{center}
\begin{tabular}{|c|c|c|c|c|c|c|}

\hline \multicolumn{7}{|c|}{Status Register (12)} \\

\hline \textbf{Field bit(s):} & 31..5 & 4   & 3 & 2   & 1 & 0  \\

\hline \textbf{Field name:}   & 0     & IEo & 0 & IEp & 0 & IEc \\

\hline

\end{tabular}

\end{center}
\caption{Format of Status register}
\label{status_reg}
\end{figure}

Detailed description for fields in figure \ref{status_reg}:

\begin{itemize}

\item \textbf{IEc}: Interrupt enable/disable flag. When software
      writes 1 to this field, interrupts are enabled. When software
      writes to this field, interrupts are disabled and do not trigger
      any exception. This field is reset to 0 by hardware on two events:

      \begin{enumerate}
      \item CPU is reset.
      \item An exception has taken place.
      \end{enumerate}

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

\end{itemize}

\item \textbf{\underline{Cause Register:}}\\

\begin{figure}[H]
\begin{center}
\begin{tabular}{|c|c|c|c|c|}

\hline \multicolumn{5}{|c|}{Cause Register (13)} \\

\hline \textbf{Field bit(s):} & 31 & 30..7 & 6..2    & 1..0 \\

\hline \textbf{Field name:}   & BD & 0     & ExcCode & 0    \\

\hline

\end{tabular}

\end{center}
\caption{Format of Cause register}
\label{cause_reg}
\end{figure}

Detailed description for fields in figure \ref{cause_reg}:

\begin{itemize}

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

\end{itemize}

\item \textbf{\underline{EPC Register:}}\\

\begin{figure}[H]
\begin{center}
\begin{tabular}{|c|c|}

\hline \multicolumn{2}{|c|}{EPC Register (14)} \\

\hline \textbf{Field bit(s):} & 31..0 \\

\hline \textbf{Field name:}   & EPC   \\

\hline

\end{tabular}

\end{center}
\caption{Format of EPC register}
\label{epc_reg}
\end{figure}

Detailed description for fields in figure \ref{epc_reg}:

\begin{itemize}

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

\end{itemize}

\end{itemize}

\subsection{Memory Management}

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

\begin{figure}[H]
\begin{center}
\begin{tikzpicture}

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

\end{tikzpicture}
\end{center}
\caption{Memory access levels}
\label{memaccess}
\end{figure}

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

\begin{enumerate}

\item \textbf{Logical address}: the address of a memory location or
an instruction from the prespective of the running program. This simply
means that a program doesn't see memory as it is in reality. The
running program doesn't need to know the real address of the memory
item it is currently addressing, but the operating system must
provide the mapping between the logical address of a memory item
and its real location in memory. This mapping is used by translation
circuitry that translates logical address to the real location
before main memory is queried.

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

\end{enumerate}

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

It's important to note that some authors use terms like
`virtual address' and `program address' to refer to logical addresses. 
We shall use the term `logical address' throughout the document to 
prevent confusion with other terms and techniques, like `virtual memory', 
which shouldn't be confused with `logical address space', or equivalently,
`logical memory'.\\

\subsubsection{MIPS Logical Address Space}

Since a logical address is 32 bits (as seen earlier), every process
shall has a logical address space of 4GB. This 4GB address space
is divided into four regions, each region is translated differently
as will be seen below. The four regions are:

\begin{enumerate}

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

\item \textbf{kseg0} 0x80000000 - 0x9FFFFFFF (512MB): 
      addresses in this region are not translated using the
      mapping provided by the OS, but rather they are translated
      by stripping off the most significant bit. Thus, this
      region simply maps to the physical region: 
      0x00000000 - 0x1FFFFFFF. Operating system kernel can
      be simply put inside the lower 512MB zone of the
      main memory, and consequently it will appear inside kseg0.
      This implies that the kernel doesn't need to setup
      any mapping for itself, it is just mapped automatically
      to this region. This also implies that kernel memory
      area is shared among all processes.

\item \textbf{kseg1} 0xA0000000 - 0xBFFFFFFF (512MB):
      just like kseg0, addresses in this region also translate
      to the lower 512MB of physical address space. The only
      difference between kseg0 and kseg1 is that memory access
      of any address in kseg1 will skip the cache, so it is
      always uncached, while kseg0 is always cached. Access
      to memory-mapped I/O registers should always be done
      through this segment (to prevent caching). System
      designers must make sure that I/O registers have
      physical addresses in the low 512MB physical zone so that
      they can appear in kseg1.

\item \textbf{kseg2} 0xC0000000 - 0xFFFFFFFF (1GB):
      any address in this region is simply translated
      using the mapping provided by the operating system,
      this area is usually used to contain OS data structures
      which are maintained by the kernel.

\end{enumerate}

We conclude that addresses in kuseg and kseg2 are translated
the same way, using the mapping provided by the operating system,
while addresses in kseg0 and kseg1 are translated by mapping them
directly to the lower 512MB zone of physical memory. The only
difference between kseg0 and kseg1 is that the former is cached
while the later is uncached. The difference between kuseg and kseg2
is that kuseg is used to hold current process code and data,
while kseg2 is used to hold kernel objects.\\

Having a static mapping for kseg0 and kseg1 has several advantages:

\begin{enumerate}

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

\end{enumerate}

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

\subsubsection{Translation Look-aside Buffer (TLB)}

Now we show how the operating system provides the CPU with a certain
mapping for current process. Since there are 3GB of the address
space (kuseg and kseg2 regions, see above) that can be dynamically
mapped to physical memory, we need a data structure that describes
how to map every logical address inside the two regions (kuseg and
kseg2) into physical address. \\

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

Since a physical address is 32 bits, we need an array of 4Gx4B which
is a 16GB data structure for every process. This is certainly
unfeasible and we would need to think for another solution.
Instead of mapping each logical address to a certain physical address,
we can map every block of logical address to a block of physical addresses.\\

Using this technique, we just need an array with n elements, where
n is number of blocks of the logical address space which is also
equal to number of block of the address space. We call this scheme
\textbf{`Paging'}, where a physical address is called a `frame'
and logical address block is called a `page'. \\

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

A page table of 4MB fo every process is still big, since when
number of processes increase, a big portion of main memory will
just be used to store page tables. Furthermore, a process
won't usually need to map the whole 4GB address space. It can leave
some pages unmapped, and only map pages where it needs to put
its code and data. Actually, the usual case is that most pages are 
unmapped. And if virtual memory is not implemented, the total
number of mapped pages across all page tables (across all processes)
must be less than or equal to size of RAM (given that no frame
is mapped to by more than one page), and RAM is usually
much smaller than 4GB.\\

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

So, how the CPU makes use of these page tables to do translation?
The processor could simply be given the base physical address
of the page directory that controls the current process. When
a logical address is generated by core processor, the translation
circuitry looks up the page directory then the corresponding 2nd-level 
page table to get frame number, as shown in the figure above.
On a process switch, the CPU is given the page directory of
next process.\\

This translation scheme requires two memory access for each translation,
which is too much since memory access takes much time, so we need
to cache page entries that are used frequently. Caching page
entries will effectively reduce average translation time.
This special-purpose cache is called \textbf{`translation
look-aside buffer'}, or simply TLB. When a logical address is generated
by core processor, TLB is queried for that logical address. If
the entry of this address is found inside TLB, the physical
address is returned immediately. If a TLB miss happens, the processor
shall access main memory to get page entry.\\

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

\begin{figure}[H]
\begin{center}
\begin{tabular}{|c|c|c|c|c|c|c|}

\hline \multicolumn{7}{|c|}{TLB Entry} \\

\hline \textbf{Field bit(s):} & 63..44 & 43..32 & 31..12 & 11..10 & 9 & 8..0 \\

\hline \textbf{Field name:}   & VPN    & 0      & PFN    & 0      & V & 0    \\

\hline

\end{tabular}

\end{center}
\caption{Format of TLB entry}
\label{tlb_entry}
\end{figure}

Fields are:

\begin{itemize}

\item \textbf{VPN}: the 20-bit logical page number to be translated.

\item \textbf{PFN}: the 20-bit physical frame number this VPN maps to.

\item \textbf{V}: valid bit. If this bit is set to 1, this is entry
      is valid and can be used for translation. If this bit is set to
      0, this entry is not valid and won't be used for translation.

\end{itemize}

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

\begin{enumerate}

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

\item The operating system reads EntryLo register using MFC0 instruction.
      Result is the lower 32 bits of the target TLB entry. 

\item The operating system reads EntryHi register using MFC0 instruction.
      Result is the upper 32 bits of the target TLB entry.

\end{enumerate}

A similar sequence could be used for writing a TLB entry 

\begin{enumerate}

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

\item The operating system writes the lower 32 bits of the target TLB
      entry into EntryLo register using MTC0 instruction.

\item The operating system writes the upper 32 bits of the target TLB
      entry into EntryHi register using MTC0 instruction.

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

\end{enumerate}

Now since the operating system has full access to TLB, paging can be
implemented easily. Whenever a logical address is generated by
the processor, the following steps happen:

\begin{enumerate}

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

\end{enumerate}

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

\begin{enumerate}

\item The OS reads the value of BadVaddr register using MFC0 instruction.

\item The OS then queries page tables to know the mapping of the address
      in BadVaddr register. If there is no mapping, the operating system
      may decide to stop the program or send an error signal for instance.
      If there is mapping, the operating system reads the physical
      frame number that this logical address maps to.

\item The operating system calculates the index of the TLB entry which
      should be modified to solve the miss. The index is actually
      equal to bits 12 to 17 (inclusive) of the logical address as
      explained above.

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

\end{enumerate}

\subsubsection{Cache Memory}

After logical address is translated into physical address, physical
address is used to access RAM. However, because memory access
takes long time (i.e, has high penalty), a cache is put
between TLB and RAM to fasten memory access time.\\

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

\begin{itemize}

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

\item \textbf{Data field}: The 4-byte datum cached by this entry.

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

\end{itemize}

Every cache has 1024 entries, resulting in two 4KB caches. The process
of looking up data in the cache is completely transparent from software.
Bits 2 to 11 (inclusive) of the physical address are used as index.
The tag of the entry at the calculated index is compared to the
higher 20 bits of the physical address. If valid bit is 1 and
comparison matches, data field of the entry is return to core processor.
If valid bit or 0 or comparison doesn't match, the CPU initiates
a memory cycle to bring data from RAM and updates the cache automatically.\\

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

\subsection{Exception Handling}

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

\begin{itemize}

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

\item \textbf{System calls}: system calls are special calls that
      transfers the control to the operating system to execute
      some kernel-level subroutine then return back to user
      program and continue execution normally. System calls
      are handled by the processor as an exception trigger:
      when system call (or breakpoint) instruction is executed,
      an exception happens.

\item \textbf{Page faults}: page faults need to be reported to
      operating system whenever they happen to fully support
      paging. When a page fault happens, the running program is 
      interrupted and exception handler is called. Exception
      handler shall handle the fault then return back to the
      running program.

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

\end{itemize}

Processor provide a mechanism to return from exception and resume
execution of the interrupted process. It's the responsibility
of the OS to store the context of the interrupted process
at beginning of exception handling, so that when the exception
handler returns back to the interrupted process, the process
continues its work normally as if nothing has happened.\\

It's the responsibility of the processor to inform software with
what kind of exception has actually happened, at which
instruction the exception has happened, and any extra parameters
needed. For example, if a program error has happened, the processor
shall inform software of which instruction has caused the error.
If a page fault happens, the processor should inform software
of which instruction caused the fault, and of the logical
address that couldn't be translated.\\

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

\subsubsection{Exception Cases}

Currently, these are all the events that cause our processor
to raise an exception:

\begin{itemize}

\item \textbf{Interrupt}: Only if IEc flag of SR register is 1,
      if IRQ signal arrives to the processor, the processor
      sets ExcCode field of Cause register to 0, copies the
      address of instruction that is currently being executed
      into EPC register, then calls exception handler. We note 
      that there is only one IRQ signal that is fed to the processor. 
      System designer should allow the IRQ signal to be shared by various
      I/O devices. Several techniques exist for sharing IRQ 
      signals.

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

\end{itemize}

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

\subsubsection{Exception Vectors}

Exception vector is the address where the exception handler is expected
to reside. When exception happens, the processor performs a far
jump to exception vector, starting from there the execution of
the exception handler. Actually, one distinct exception vector
could be assigned to every type of exception. In this case,
there is an exception handler for every type of exception.\\

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

Dynamic vectors are set up by software. They could be stored inside
one or more registers in the processor or could be stored in a table.
The table will contains vectors for all possible exception types.
Examples for architecture using dynamic vector mechanism include
x86 and Zilog Z80. In some architectures, like 68K and PDP-11,
the interrupting I/O device itself provides the processor
with the interrupt vector when an interrupt is handled.\\ 

Since MIPS processors use static hard-wired exception vectors, our
processor jumps to predefined addresses when exceptions happens.
Figure \ref{vectors} lists those predefined addresses and their
associated exceptions.

\begin{figure}[H]
\begin{center}
\begin{tabular}{|c|c|c|c|}

\hline \textbf{Logical Address} & \textbf{Region} & 
       \textbf{Physical Address} & \textbf{Exception Types} \\

\hline 0xBFC00180  & kseg1 & 0x1FC00180 & All types of exception, except reset. \\

\hline 0xBFC00000  & kseg1 & 0x1FC00000 & Reset exceptions.\\

\hline

\end{tabular}
\end{center}
\caption{Excetion vectors for various exception types}
\label{vectors}
\end{figure}

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

\subsubsection{Exception Protocol}

Except for reset exceptions, the processor does the following when
an exception happens:

\begin{enumerate}

\item Copy the address of the instruction that causes the
      exception into EPC register.

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

\end{enumerate}

The exception handler should go through these steps:

\begin{enumerate}

\item Store the state (context) of the interrupted program. EPC
      should also be stored.

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

\item Restore the state of the interrupted program.

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

\end{enumerate}

\subsubsection{Precise Exceptions}

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

To handle these pipeline issues, exceptions need to be `precise'.
An exception is called precise if the saved processor state
corresponds with the sequential model of the program execution,
although the underlying hardware excutes instructions in parallel
and out of order. In the case of precise exceptions, the OS
knows well that all instructions before the instruction referred
to by EPC have finished their execution successfully, and have
already committed their results. The OS also knows that
all instructions after EPC has never been executed and didn't
effect the processor state. These two points is what we mean
by saying that the saved processor state corresponds with
the sequential model of execution.\\

Since our prcoessor implements precise exceptions, it guarantees
the following:

\begin{itemize}

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

\item \textbf{Exceptions are seen in instruction sequence}:
       as described above, precise exceptions guarantees that
       all instructions before EPC has finished their execution
       successfully. If several exceptions at several stages happen 
       at the same time, the processor choose the earlier instruction
       of them to be put in EPC. When an exception happens
       at some stage of the pipeline, exception handler is not
       called until all instructions in the following stages finish
       execution and commit their results.

\item \textbf{Subsequent instructions nullified}:
      all the stages before the stage that caused the exception
      are nullified and any change that happened by instructions
      in these stages is undone. This guarantees that all instructions
      after EPC can be restarted safely after exception handler returns.

\end{itemize}

\end{document}
