iocoder/graduation/doc/book/cover.pdf

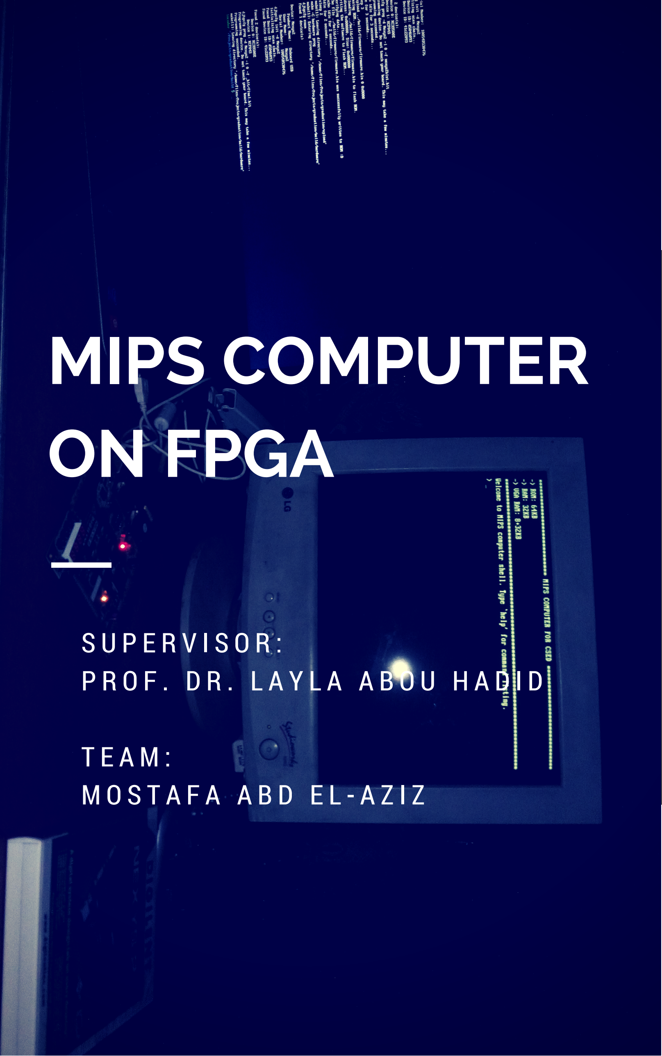
[picture p79: page 1]

# MIPS COMPUTER ON FPGA

S U P E R V I S O R :
P R O F . D R . L A Y L A A B O U H A D I D

T E A M :
M O S T A F A A B D E L - A Z I Z
