iocoder/graduation/doc/isis/pipeline.PDF

FILE NAME:

BY:

DATE:

PAGE:

# hardware/cpu/pipeline.vhd

10/30/2015

Mostafa Abd El-Aziz

A | B | C | D | E | F | G | H | J | K
A | B | C | D | E | F | G | H | J | K

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
SHEET: | 3
1 | of | 1
REV: | 1.0 | TIME: | 9:25:32 AM
DESIGN TITLE: | CPU Pipeline
