iocoder/graduation/doc/pipeline/pipeline.png

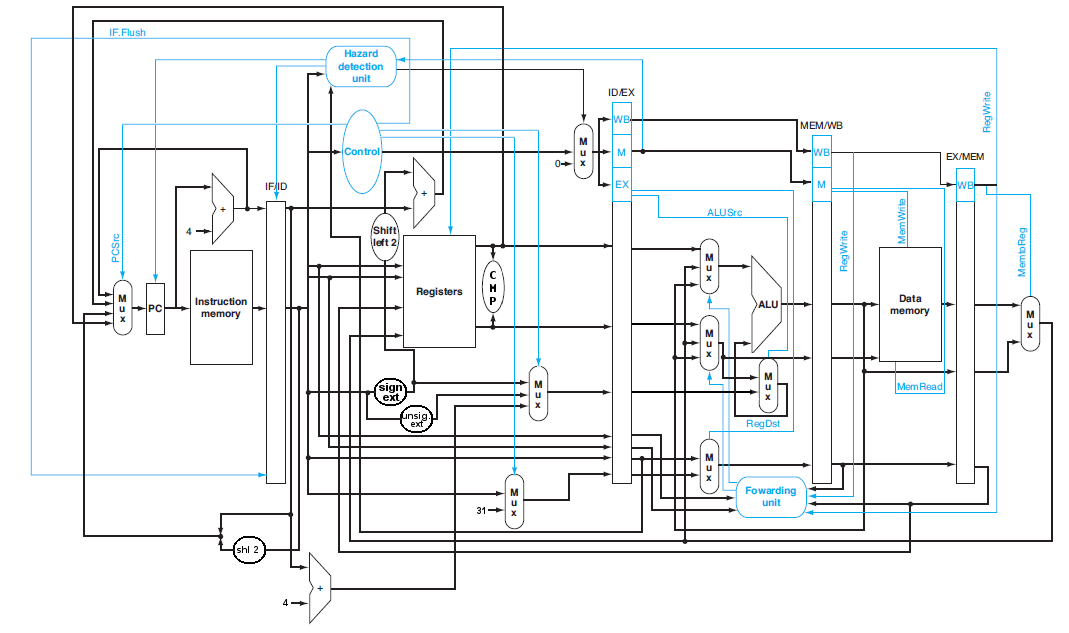
doc/pipeline/pipeline.png
