iocoder/graduation/doc/proposal/quaf1.png

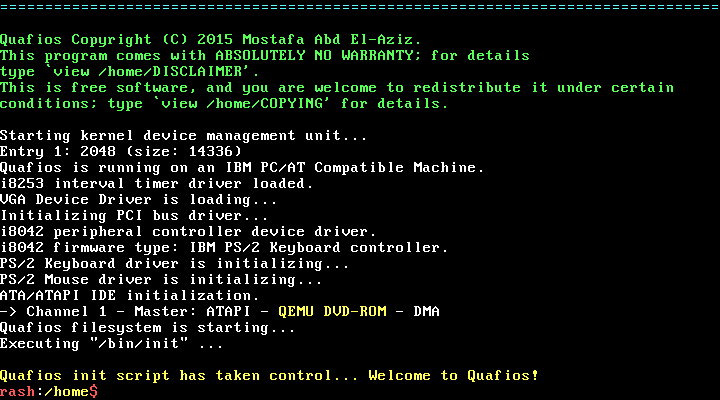
doc/proposal/quaf1.png
