iocoder/graduation/doc/proposal/quaf12.png

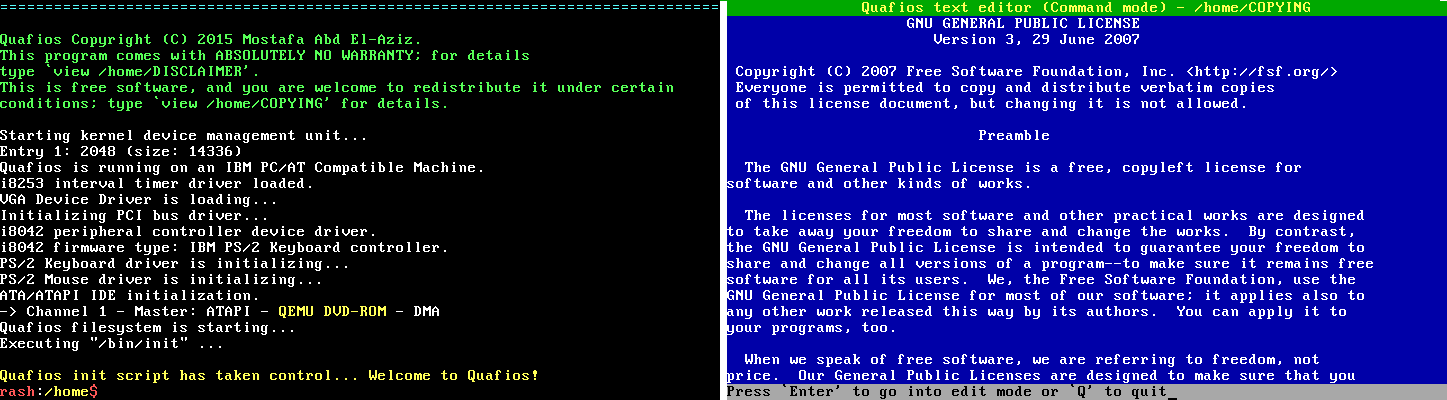
doc/proposal/quaf12.png
