iocoder/graduation/doc/shots/6502.png

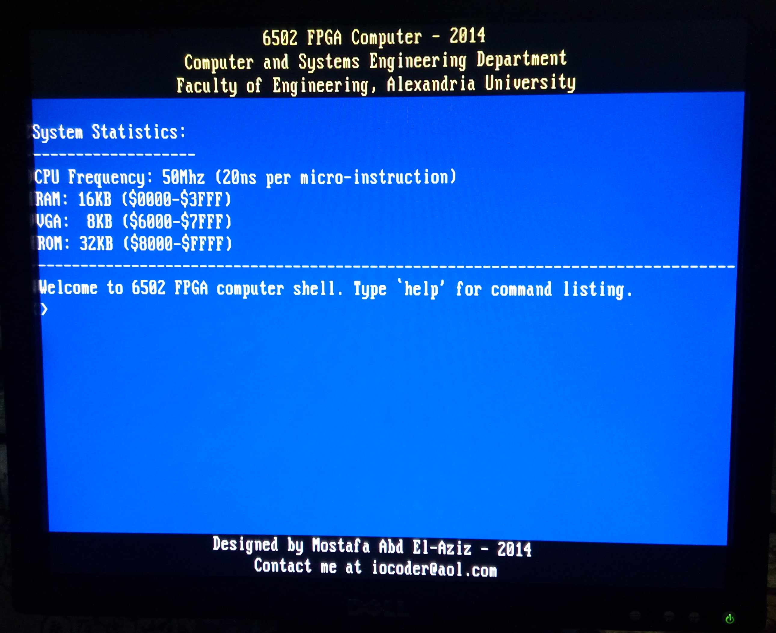
doc/shots/6502.png
