iocoder/graduation/doc/shots/pic1.png

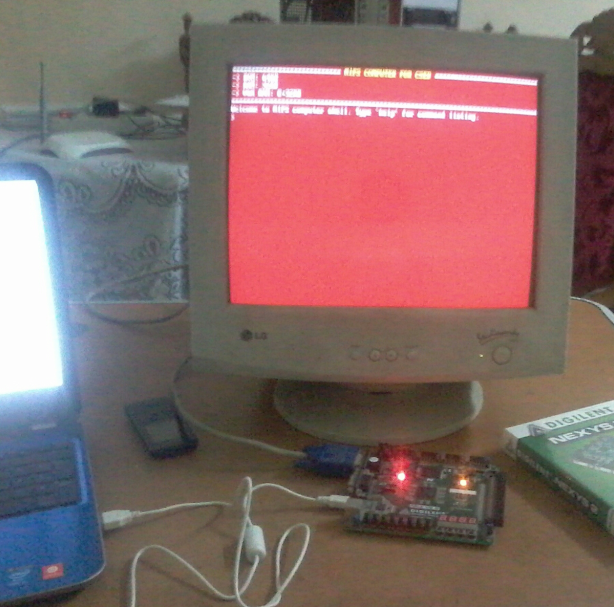
doc/shots/pic1.png
