iocoder/graduation/doc/shots/pic2.png

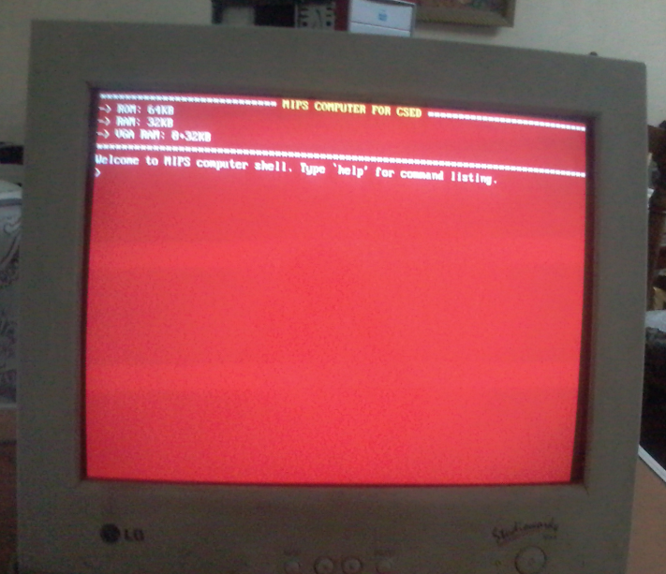
doc/shots/pic2.png
