iocoder/graduation/doc/book/logo.pdf

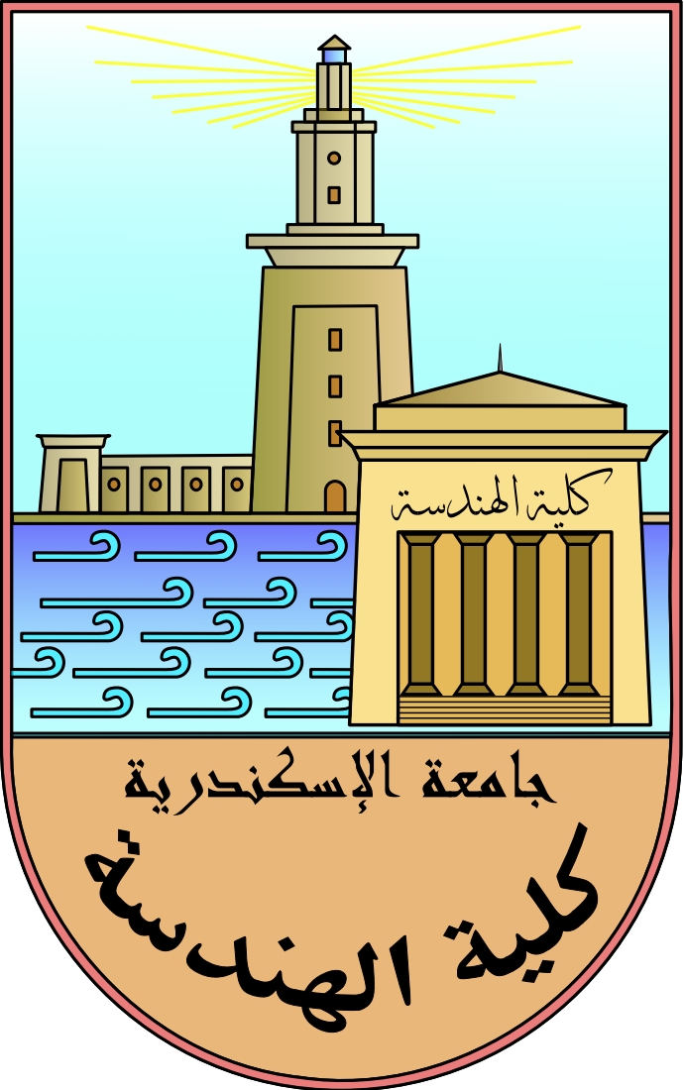
[picture p100: page 1]
