iocoder/graduation/(list of files, drawings)

Other design files:
doc/isis/cpu.pdsprj
doc/isis/designs.dsn
doc/isis/designs.pdsprj
doc/isis/pipeline.pdsprj
doc/isis/tlc.pdsprj
doc/isis/vga.pdsprj
