iocoder/graduation/quafios/edit/main.c

/*
 *        +----------------------------------------------------------+
 *        | +------------------------------------------------------+ |
 *        | |  Quafios Text Editor.                                | |
 *        | |  -> main() procedure.                                | |
 *        | +------------------------------------------------------+ |
 *        +----------------------------------------------------------+
 *
 * This file is part of Quafios 2.0.1 source code.
 * Copyright (C) 2015  Mostafa Abd El-Aziz Mohamed.
 *
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
 * Visit http://www.quafios.com/ for contact information.
 *
 */

#include <stdio.h>
#include <stdlib.h>

int main(int argc, char *argv[]) {

    char *filename;

    if (argc < 2) {
        filename = malloc(200);
        filename[0] = 0;
        while (!filename[0]) {
            printf("Enter filename: ");
            scanf("%s", filename);
        }
        getchar(); /* flush \n */
    } else {
        filename = argv[1];
    }

    if (file_load(filename)) {
        printf("can't open %s\n", filename);
        return -1;
    }


    console_init();
    command_mode();

    /*if (!strcmp(&argv[0][strlen(argv[0])-4], "view")) {
        extern int fileModified;
        if (fileModified) {
            printf("can't read %s\n", filename);
            return -1;
        }
        console_init();
        view_mode();
    } else {
        printf("Console initalization!\n");
        console_init();
        command_mode();
    }*/

    console_black();
    return 0;

}
