iocoder/graduation/firmware/main.c

#include "vga.h"
#include "kbd.h"
#include "pit.h"
#include "pic.h"
#include "isr.h"
#include "rom.h"
#include "sdcard.h"

int main() {

    /* initialize PIC */
    pic_init();

    /* initialize ISR */
    isr_init();

    /* initialize VGA... */
    vga_init();

    /* initialize PIT */
    //pit_init();

    /* initialize keyboard */
    kbd_init();

    /* initialize ROM */
    rom_init();

    /* initialize SDCard */
    sdcard_init();

    /* initialize BIOS structure */
    bios_init();

    /* draw faculty logo */
    draw_logo();

    /* print computer card */
    card();

    /* perform PoST */
    post();

    /* boot the machine */
    boot();

    /* return 0 */
    return 0;

}
