iocoder/graduation/mipsemu/main.c

#include <stdio.h>
#include <SDL2/SDL.h>

#include "clock.h"
#include "vga.h"
#include "cpu.h"
#include "kbd.h"
#include "mem.h"
#include "pit.h"
#include "pic.h"
#include "ppu.h"

int main(int argc, char *argv[]) {

    SDL_Thread *t;

    /* check the arguments */
    if (argc != 3) {
        fprintf(stderr, "Invalid arguments. Usage: ");
        fprintf(stderr, "%s <firmware> <sdcard.img>\n", argv[0]);
        return -1;
    }

    /* print splash */
    printf("*********************************\n");
    printf("*  MIPS FPGA COMPUTER EMULATOR  *\n");
    printf("*********************************\n");
    printf("\n");

    /* loading... */
    printf("The emulator is loading...\n");

    /* initialize SDL */
    SDL_Init(SDL_INIT_EVERYTHING);

    /* initialize memory */
    mem_init(argv[1], argv[2]);

    /* initialize CPU */
    cpu_init();

    /* initialize PPU */
    ppu_init();

    /* initialize VGA */
    vga_init();

    /* initialize keyboard */
    kbd_init();

    /* initialize PIT */
    pit_init();

    /* initialize PIC */
    pic_init();

    /* create execution thread */
    t = SDL_CreateThread(clock_handler, (void *)NULL, NULL);

    /* run event watcher */
    watch_events(t);

    /* quit SDL */
    SDL_Quit();

    /* done */
    return 0;

}
