iocoder/graduation/hardware/vga/vga.vhd

library IEEE;
use IEEE.STD_LOGIC_1164.ALL;
use IEEE.STD_LOGIC_ARITH.ALL;
use IEEE.STD_LOGIC_UNSIGNED.ALL;

entity vga is
    Port ( CLK  : in  STD_LOGIC; -- 50MHz clock input
           -- System Bus
           CS   : in  STD_LOGIC;
           RW   : in  STD_LOGIC;
           A    : in  STD_LOGIC_VECTOR (13 downto 0);
           Din  : in  STD_LOGIC_VECTOR (15 downto 0);
           Dout : out STD_LOGIC_VECTOR (15 downto 0);
           RDY  : out STD_LOGIC := '0';
           INT  : out STD_LOGIC := '0';
           IAK  : in  STD_LOGIC;
           -- VGA Port
           R    : out STD_LOGIC_VECTOR (2 downto 0);
           G    : out STD_LOGIC_VECTOR (2 downto 0);
           B    : out STD_LOGIC_VECTOR (1 downto 0);
           HS   : out STD_LOGIC;
           VS   : out STD_LOGIC);
end vga;

architecture Structural of vga is

component clkgen is
    Port (CLK       : in  STD_LOGIC;
          CLK_56MHz : out STD_LOGIC;
          CLK_50MHz : out STD_LOGIC;
          CLK_28MHz : out STD_LOGIC;
          CLK_25MHz : out STD_LOGIC;
          CLK_12MHz : out STD_LOGIC);
end component;

component graphics is
    Port ( CLK50       : in  STD_LOGIC;
           CLK12       : in  STD_LOGIC;
           CS          : in  STD_LOGIC;
           RW          : in  STD_LOGIC;
           A           : in  STD_LOGIC_VECTOR (13 downto 0);
           Din         : in  STD_LOGIC_VECTOR (15 downto 0);
           Dout        : out STD_LOGIC_VECTOR (15 downto 0);
           INT         : out STD_LOGIC := '0';
           IAK         : in  STD_LOGIC;
           VBLANK      : in  STD_LOGIC;
           VRAM0Read   : out STD_LOGIC;
           VRAM1Read   : out STD_LOGIC;
           VRAM2Read   : out STD_LOGIC;
           VRAM3Read   : out STD_LOGIC;
           VRAM4Read   : out STD_LOGIC;
           VRAM0Write  : out STD_LOGIC;
           VRAM1Write  : out STD_LOGIC;
           VRAM2Write  : out STD_LOGIC;
           VRAM3Write  : out STD_LOGIC;
           VRAM4Write  : out STD_LOGIC;
           VRAMAddr    : out STD_LOGIC_VECTOR (10 downto 0);
           VRAM0DataIn : in  STD_LOGIC_VECTOR ( 8 downto 0);
           VRAM1DataIn : in  STD_LOGIC_VECTOR ( 8 downto 0);
           VRAM2DataIn : in  STD_LOGIC_VECTOR ( 8 downto 0);
           VRAM3DataIn : in  STD_LOGIC_VECTOR ( 8 downto 0);
           VRAM4DataIn : in  STD_LOGIC_VECTOR ( 8 downto 0);
           VRAMDataOut : out STD_LOGIC_VECTOR ( 8 downto 0);
           SprRD       : out STD_LOGIC;
           SprWR       : out STD_LOGIC;
           SprAddr     : out STD_LOGIC_VECTOR ( 7 downto 0);
           SprDataIn   : in  STD_LOGIC_VECTOR ( 7 downto 0);
           SprDataOut  : out STD_LOGIC_VECTOR ( 7 downto 0);
           PalRD       : out STD_LOGIC;
           PalWR       : out STD_LOGIC;
           PalAddr     : out STD_LOGIC_VECTOR ( 4 downto 0);
           PalDataIn   : in  STD_LOGIC_VECTOR ( 7 downto 0);
           PalDataOut  : out STD_LOGIC_VECTOR ( 7 downto 0);
           ROW_BASE    : out STD_LOGIC_VECTOR ( 7 downto 0);
           CURSOR_ROW  : out STD_LOGIC_VECTOR ( 7 downto 0);
           CURSOR_COL  : out STD_LOGIC_VECTOR ( 7 downto 0);
           PPU_CTRL    : out STD_LOGIC_VECTOR (15 downto 0) := x"0000";
           PPU_HSCR    : out STD_LOGIC_VECTOR ( 7 downto 0) := x"00";
           PPU_VSCR    : out STD_LOGIC_VECTOR ( 7 downto 0) := x"00";
           MODE        : out STD_LOGIC);
end component;

component vgaram is
    Port (CLK           : in  STD_LOGIC;
          -- sequencer port:
          SeqReadEnable : in  STD_LOGIC;
          SeqAddr       : in  STD_LOGIC_VECTOR (10 downto 0);
          SeqDataOut    : out STD_LOGIC_VECTOR ( 8 downto 0) := "000000000";
          -- GU port:
          GUReadEnable  : in  STD_LOGIC;
          GUWriteEnable : in  STD_LOGIC;
          GUAddr        : in  STD_LOGIC_VECTOR (10 downto 0);
          GUDataIn      : in  STD_LOGIC_VECTOR ( 8 downto 0);
          GUDataOut     : out STD_LOGIC_VECTOR ( 8 downto 0));
end component;

component sequencer is
    Port (CLK56      : in  STD_LOGIC;
          CLK28      : in  STD_LOGIC;
          SE         : in  STD_LOGIC;
          MODE       : in  STD_LOGIC;
          ROW_BASE   : in  STD_LOGIC_VECTOR ( 7 downto 0);
          CURSOR_ROW : in  STD_LOGIC_VECTOR ( 7 downto 0);
          CURSOR_COL : in  STD_LOGIC_VECTOR ( 7 downto 0);
          PPU_CTRL   : in  STD_LOGIC_VECTOR (15 downto 0);
          PPU_HSCR   : in  STD_LOGIC_VECTOR ( 7 downto 0);
          PPU_VSCR   : in  STD_LOGIC_VECTOR ( 7 downto 0);
          X          : in  STD_LOGIC_VECTOR (15 downto 0);
          Y          : in  STD_LOGIC_VECTOR (15 downto 0);
          B9         : in  STD_LOGIC := '0';
          VRAM0Read  : out STD_LOGIC;
          VRAM0Addr  : out STD_LOGIC_VECTOR (10 downto 0);
          VRAM0Data  : in  STD_LOGIC_VECTOR ( 8 downto 0);
          VRAM1Read  : out STD_LOGIC;
          VRAM1Addr  : out STD_LOGIC_VECTOR (10 downto 0);
          VRAM1Data  : in  STD_LOGIC_VECTOR ( 8 downto 0);
          VRAM2Read  : out STD_LOGIC;
          VRAM2Addr  : out STD_LOGIC_VECTOR (10 downto 0);
          VRAM2Data  : in  STD_LOGIC_VECTOR ( 8 downto 0);
          VRAM3Read  : out STD_LOGIC;
          VRAM3Addr  : out STD_LOGIC_VECTOR (10 downto 0);
          VRAM3Data  : in  STD_LOGIC_VECTOR ( 8 downto 0);
          VRAM4Read  : out STD_LOGIC := '0';
          VRAM4Addr  : out STD_LOGIC_VECTOR (10 downto 0);
          VRAM4Data  : in  STD_LOGIC_VECTOR ( 8 downto 0);
          SprRD      : in  STD_LOGIC;
          SprWR      : in  STD_LOGIC;
          SprAddr    : in  STD_LOGIC_VECTOR ( 7 downto 0);
          SprDataIn  : in  STD_LOGIC_VECTOR ( 7 downto 0);
          SprDataOut : out STD_LOGIC_VECTOR ( 7 downto 0);
          PalRD      : in  STD_LOGIC;
          PalWR      : in  STD_LOGIC;
          PalAddr    : in  STD_LOGIC_VECTOR ( 4 downto 0);
          PalDataIn  : in  STD_LOGIC_VECTOR ( 7 downto 0);
          PalDataOut : out STD_LOGIC_VECTOR ( 7 downto 0);
          Color      : out STD_LOGIC_VECTOR ( 5 downto 0));
end component;

component dac is
    Port (DE    : in  STD_LOGIC;
          MODE  : in  STD_LOGIC;
          COLOR : in  STD_LOGIC_VECTOR (5 downto 0);
          R     : out STD_LOGIC_VECTOR (2 downto 0);
          G     : out STD_LOGIC_VECTOR (2 downto 0);
          B     : out STD_LOGIC_VECTOR (1 downto 0));
end component;

component crt is
    Port (CLK    : in  STD_LOGIC;
          MODE   : in  STD_LOGIC;
          VBLANK : out STD_LOGIC;
          HS     : out STD_LOGIC := '0';
          VS     : out STD_LOGIC := '0';
          SE     : out STD_LOGIC := '0';
          DE     : out STD_LOGIC := '0';
          X      : out STD_LOGIC_VECTOR (15 downto 0) := "0000000000000000";
          Y      : out STD_LOGIC_VECTOR (15 downto 0) := "0000000000000000";
          B9     : out STD_LOGIC := '0');
end component;

signal CLK_56MHz       : STD_LOGIC;
signal CLK_50MHz       : STD_LOGIC;
signal CLK_28MHz       : STD_LOGIC;
signal CLK_25MHz       : STD_LOGIC;
signal CLK_12MHz       : STD_LOGIC;

signal VRAM0Read       : STD_LOGIC;
signal VRAM1Read       : STD_LOGIC;
signal VRAM2Read       : STD_LOGIC;
signal VRAM3Read       : STD_LOGIC;
signal VRAM4Read       : STD_LOGIC;

signal VRAM0Write      : STD_LOGIC;
signal VRAM1Write      : STD_LOGIC;
signal VRAM2Write      : STD_LOGIC;
signal VRAM3Write      : STD_LOGIC;
signal VRAM4Write      : STD_LOGIC;

signal VRAMAddrFromGU  : STD_LOGIC_VECTOR (10 downto 0);
signal VRAM0DataToGU   : STD_LOGIC_VECTOR ( 8 downto 0);
signal VRAM1DataToGU   : STD_LOGIC_VECTOR ( 8 downto 0);
signal VRAM2DataToGU   : STD_LOGIC_VECTOR ( 8 downto 0);
signal VRAM3DataToGU   : STD_LOGIC_VECTOR ( 8 downto 0);
signal VRAM4DataToGU   : STD_LOGIC_VECTOR ( 8 downto 0);
signal VRAMDataFromGU  : STD_LOGIC_VECTOR ( 8 downto 0);

signal ROW_BASE        : STD_LOGIC_VECTOR ( 7 downto 0);
signal CURSOR_ROW      : STD_LOGIC_VECTOR ( 7 downto 0);
signal CURSOR_COL      : STD_LOGIC_VECTOR ( 7 downto 0);
signal MODE            : STD_LOGIC;
signal PPU_CTRL        : STD_LOGIC_VECTOR (15 downto 0);
signal PPU_HSCR        : STD_LOGIC_VECTOR ( 7 downto 0);
signal PPU_VSCR        : STD_LOGIC_VECTOR ( 7 downto 0);

signal VBLANK          : STD_LOGIC;
signal SE              : STD_LOGIC;
signal DE              : STD_LOGIC;
signal X               : STD_LOGIC_VECTOR (15 downto 0);
signal Y               : STD_LOGIC_VECTOR (15 downto 0);
signal B9              : STD_LOGIC;
signal COLOR           : STD_LOGIC_VECTOR ( 5 downto 0);

signal VRAM0ReadEnable : STD_LOGIC;
signal VRAM0ReadAddr   : STD_LOGIC_VECTOR (10 downto 0);
signal VRAM0ReadData   : STD_LOGIC_VECTOR ( 8 downto 0);

signal VRAM1ReadEnable : STD_LOGIC;
signal VRAM1ReadAddr   : STD_LOGIC_VECTOR (10 downto 0);
signal VRAM1ReadData   : STD_LOGIC_VECTOR ( 8 downto 0);

signal VRAM2ReadEnable : STD_LOGIC;
signal VRAM2ReadAddr   : STD_LOGIC_VECTOR (10 downto 0);
signal VRAM2ReadData   : STD_LOGIC_VECTOR ( 8 downto 0);

signal VRAM3ReadEnable : STD_LOGIC;
signal VRAM3ReadAddr   : STD_LOGIC_VECTOR (10 downto 0);
signal VRAM3ReadData   : STD_LOGIC_VECTOR ( 8 downto 0);

signal VRAM4ReadEnable : STD_LOGIC;
signal VRAM4ReadAddr   : STD_LOGIC_VECTOR (10 downto 0);
signal VRAM4ReadData   : STD_LOGIC_VECTOR ( 8 downto 0);

signal SprRD           : STD_LOGIC;
signal SprWR           : STD_LOGIC;
signal SprAddr         : STD_LOGIC_VECTOR ( 7 downto 0);
signal SprDataIn       : STD_LOGIC_VECTOR ( 7 downto 0);
signal SprDataOut      : STD_LOGIC_VECTOR ( 7 downto 0);

signal PalRD           : STD_LOGIC;
signal PalWR           : STD_LOGIC;
signal PalAddr         : STD_LOGIC_VECTOR ( 4 downto 0);
signal PalDataIn       : STD_LOGIC_VECTOR ( 7 downto 0);
signal PalDataOut      : STD_LOGIC_VECTOR ( 7 downto 0);

begin

u0: clkgen    port map (CLK, CLK_56MHz, CLK_50MHz, CLK_28MHz,
                        CLK_25MHz, CLK_12MHz);
u1: graphics  port map (CLK, CLK_12MHz, CS, RW, A, Din, Dout,
                        INT, IAK, VBLANK,
                        VRAM0Read, VRAM1Read, VRAM2Read,
                        VRAM3Read, VRAM4Read,
                        VRAM0Write, VRAM1Write, VRAM2Write,
                        VRAM3Write, VRAM4Write,
                        VRAMAddrFromGU,
                        VRAM0DataToGU, VRAM1DataToGU, VRAM2DataToGU,
                        VRAM3DataToGU, VRAM4DataToGU, VRAMDataFromGU,
                        SprRD, SprWR, SprAddr, SprDataOut, SprDataIn,
                        PalRD, PalWR, PalAddr, PalDataOut, PalDataIn,
                        ROW_BASE, CURSOR_ROW, CURSOR_COL,
                        PPU_CTRL, PPU_HSCR, PPU_VSCR, MODE);
u2: vgaram    port map (CLK_56MHz,
                        VRAM0ReadEnable, VRAM0ReadAddr, VRAM0ReadData,
                        VRAM0Read, VRAM0Write,
                        VRAMAddrFromGU, VRAMDataFromGU, VRAM0DataToGU);
u3: vgaram    port map (CLK_56MHz,
                        VRAM1ReadEnable, VRAM1ReadAddr, VRAM1ReadData,
                        VRAM1Read, VRAM1Write,
                        VRAMAddrFromGU, VRAMDataFromGU, VRAM1DataToGU);
u4: vgaram    port map (CLK_56MHz,
                        VRAM2ReadEnable, VRAM2ReadAddr, VRAM2ReadData,
                        VRAM2Read, VRAM2Write,
                        VRAMAddrFromGU, VRAMDataFromGU, VRAM2DataToGU);
u5: vgaram    port map (CLK_56MHz,
                        VRAM3ReadEnable, VRAM3ReadAddr, VRAM3ReadData,
                        VRAM3Read, VRAM3Write,
                        VRAMAddrFromGU, VRAMDataFromGU, VRAM3DataToGU);
u6: vgaram    port map (CLK_56MHz,
                        VRAM4ReadEnable, VRAM4ReadAddr, VRAM4ReadData,
                        VRAM4Read, VRAM4Write,
                        VRAMAddrFromGU, VRAMDataFromGU, VRAM4DataToGU);
u7: sequencer port map (CLK_56MHz, CLK_28MHz, SE,
                        MODE, ROW_BASE, CURSOR_ROW, CURSOR_COL,
                        PPU_CTRL, PPU_HSCR, PPU_VSCR,
                        X, Y, B9,
                        VRAM0ReadEnable, VRAM0ReadAddr, VRAM0ReadData,
                        VRAM1ReadEnable, VRAM1ReadAddr, VRAM1ReadData,
                        VRAM2ReadEnable, VRAM2ReadAddr, VRAM2ReadData,
                        VRAM3ReadEnable, VRAM3ReadAddr, VRAM3ReadData,
                        VRAM4ReadEnable, VRAM4ReadAddr, VRAM4ReadData,
                        SprRD, SprWR, SprAddr, SprDataIn, SprDataOut,
                        PalRD, PalWR, PalAddr, PalDataIn, PalDataOut,
                        COLOR);
u8: dac       port map (DE, MODE, COLOR, R, G, B);
u9: crt       port map (CLK_28MHz, MODE, VBLANK, HS, VS, SE, DE, X, Y, B9);

end Structural;
