iocoder/graduation/mipsemu/vga.c

#include <stdio.h>
#include <stdlib.h>
#include <SDL2/SDL.h>

#include "vga.h"

static SDL_Window* window;
static SDL_Renderer* renderer;
static SDL_Texture* texture;
static Uint32 pixels[720*400];
unsigned char chr[80*30];
unsigned char att[80*30];
unsigned short font[256][16];
int base = 0;
int close_thread = 0;
int thread_closed = 0;
static Uint32 palette[] = {
     0x000000,
     0x0000AA,
     0x00AA00,
     0x00AAAA,
     0xAA0000,
     0xAA00AA,
     0xAA5500,
     0xAAAAAA,
     0x555555,
     0x5555FF,
     0x55FF55,
     0x55FFFF,
     0xFF5555,
     0xFF55FF,
     0xFFFF55,
     0xFFFFFF
};

void set_fpx(int x, int y, Uint32 color) {
    pixels[(y*720)+x] = color;
}

void update_char(int loc, unsigned char ascii, unsigned char attrib) {

    int row, col;
    int j, k;
    Uint32 fg = palette[(attrib>>0)&0xF];
    Uint32 bg = palette[(attrib>>4)&0xF];

    /* update buffers */
    chr[loc] = ascii;
    att[loc] = attrib;

    /* adjust loc */
    loc = (loc-base+2000)%2000;
    row = loc/80;
    col = loc%80;

    /* update screen */
    for (j = 0; j < 9; j++)
        for (k = 0; k < 16; k++) {
            if (font[ascii][k]&(1<<(8-j))) {
                set_fpx(col*9+j, row*16+k, fg);
            } else {
                set_fpx(col*9+j, row*16+k, bg);
            }
        }

}

void refresh() {
    int i;
    for (i = 0; i < 2000; i++)
        update_char(i, chr[i], att[i]);
}

void vga_write(unsigned short addr, unsigned int data) {
    int loc;
    if (addr & 0x1000) {
        /* font */
        font[(addr & 0x0FF0)>>4][addr&0x0F] = data;
    } else if (addr < 4000) {
        /* data */
        loc = (addr & 0x0FFF)>>1;
        if (addr & 1) {
            update_char(loc, chr[loc], data);
        } else {
            update_char(loc, data, att[loc]);
        }
    } else {
        /* special registers */
        if (addr == 0xFFD) {
            base = data*80;
            refresh();
        } else if (addr == 0xFF8) {
            if (data == 1) {
                /* debugging */
                static unsigned int total = 0;
                static unsigned int last = 0;
                static unsigned int count = 0;
                extern unsigned int total_cycles;
                count++;
                if (count > 1) {
                    total += total_cycles-last;
                    printf("count: %d, avg: %d\n", count, total/count);
                }
                last = total_cycles;

            } else {
                printf("%c", data);
            }
        }
    }
}

void vga_render() {
    SDL_UpdateTexture(texture, NULL, &pixels[0], 1);
    SDL_RenderCopy(renderer, texture, NULL, NULL);
    SDL_RenderPresent(renderer);
}

int vga_update() {
    while(!close_thread) {
    }
    thread_closed = 1;
    return 1;
}

void vga_stop() {
    close_thread = 1;
    while (!thread_closed);
}

void vga_init() {

    FILE *f;
    int i;

    /* create vga window */
    window = SDL_CreateWindow("MIPS FPGA Computer Emulator",
        SDL_WINDOWPOS_CENTERED, SDL_WINDOWPOS_CENTERED,
        720, 400, 0);

    /* create renderer */
    renderer = SDL_CreateRenderer(window, -1, SDL_RENDERER_ACCELERATED);

    /* create texture */
    texture = SDL_CreateTexture(renderer,
        SDL_PIXELFORMAT_ARGB8888, SDL_TEXTUREACCESS_STREAMING,
        720, 400);

    /* initialize screen */
    for (i = 0; i < 80*25; i++)
        update_char(i, 0, 0x11);

}
