iocoder/graduation/quafios/kernel/arch/i386/spinlock.c

/*
 *        +----------------------------------------------------------+
 *        | +------------------------------------------------------+ |
 *        | |  Quafios Kernel 2.0.1.                               | |
 *        | |  -> i386: spinlocks.                                 | |
 *        | +------------------------------------------------------+ |
 *        +----------------------------------------------------------+
 *
 * This file is part of Quafios 2.0.1 source code.
 * Copyright (C) 2015  Mostafa Abd El-Aziz Mohamed.
 *
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
 * Visit http://www.quafios.com/ for contact information.
 *
 */

#ifdef ARCH_I386

#include <i386/spinlock.h>
#include <i386/type.h>
#include <i386/asm.h>
#include <i386/stack.h>
#include <sys/mm.h>
#include <sys/scheduler.h>

void spinlock_init(spinlock_t *spinlock) {
    /* initialize spinlock to 0 (currently not acquired) */
    *spinlock = 0;
}

void spinlock_acquire(spinlock_t *spinlock) {
    /* x86 bts (bit test and set) instruction just works as follows:
     * load the current value of the targeted bit into CF flag (test)
     * set the value of the targeted bit to 1 (set).
     * LOCK prefix guarantees that this operation is atomic and no
     * memory access by any other CPU happens between the set
     * and test operation (it actually locks the bus).
     *
     * You may refer to the OS bible (2.2.3 - mutual exclusion) for
     * information about test and set lock (TSL) instructions. BTS
     * is also equivalent in some sense to the compare_and_swap()
     * instruction described in Stallings (5.2, 7th edition) with
     * *word = *spinlock, testval = 0, and newval = 1.
     */
    /*if (scheduler_enabled && !(get_eflags() & 0x200)) {
        Regs regs = {0};
        __asm__("mov ., %%eax":"=a"(regs.eip));
        __asm__("mov %%ebp, %%eax":"=a"(regs.ebp));
        panic(&regs, "Error: spinlock_acquire() from interrupt context!");
    }*/

    __asm__("1: lock bts $0, (%%esi);\n"
            "   jc       1b         ;\n"::"S"(spinlock));
}


void spinlock_release(spinlock_t *spinlock) {
    /* set spinlock to zero to let other processes
     * be able to hold it by spinlock_acquire().
     */
    *spinlock = 0;
}

#else

typedef int dummy;

#endif
