iocoder/graduation/firmware/kbd.h

#ifndef _MIPSCOMP_KBD_H
#define _MIPSCOMP_KBD_H

#define KBD_BUF_SIZE    16
#define KBD_BASE        0xBE800000
#define KBD_DATA        0
#define KBD_STATUS      1

char getc();
void scan_char(char *c);
void scan_str(char *str);
int scan_int(int *num);
void kbd_init();

#endif
