iocoder/graduation/(commit log)

2015-09-07 replaced (loc) with (row) and (col)
    [vga.c]
2015-10-30 Added some schematics using Proteus ISIS
    [cpu.pdsprj, designs.dsn, designs.pdsprj, pipeline.pdsprj, tlc.pdsprj, vga.pdsprj]
2015-11-01 implemented 720x400@70Hz vga mode
2015-12-18 resolved clk constraints and added interrupts
    [cache.vhd, clkdiv.vhd, cpu.vhd, graphics.vhd, main.c, pipeline.vhd, vga.h]
2015-12-18 implemented pic and kbd interrupts
2015-12-27 added Quafios
    [hvm_domu_quafios.cfg, ich9-ehci-uhci.cfg]
2016-03-06 solved a bug in rfe instruction
    [init.c, irq.c, pipeline.vhd]
2016-03-06 solved a bug in SR shift (emulator)
    [cpu.c]
2016-03-06 added quafios device drivers
2016-03-07 implemented interrupts in Quafios
2016-03-07 implemented timer and kbd drivers
2016-03-08 solved isr bug & enabled disk detection
    [bios.c, bios.h, bootinfo.c, bootinfo.h, cpu.c, diskfs.c]
